HarshParmar029/ESP32-Smart-Visitor-Counter/ESP32_Visitor_Counter.pdf

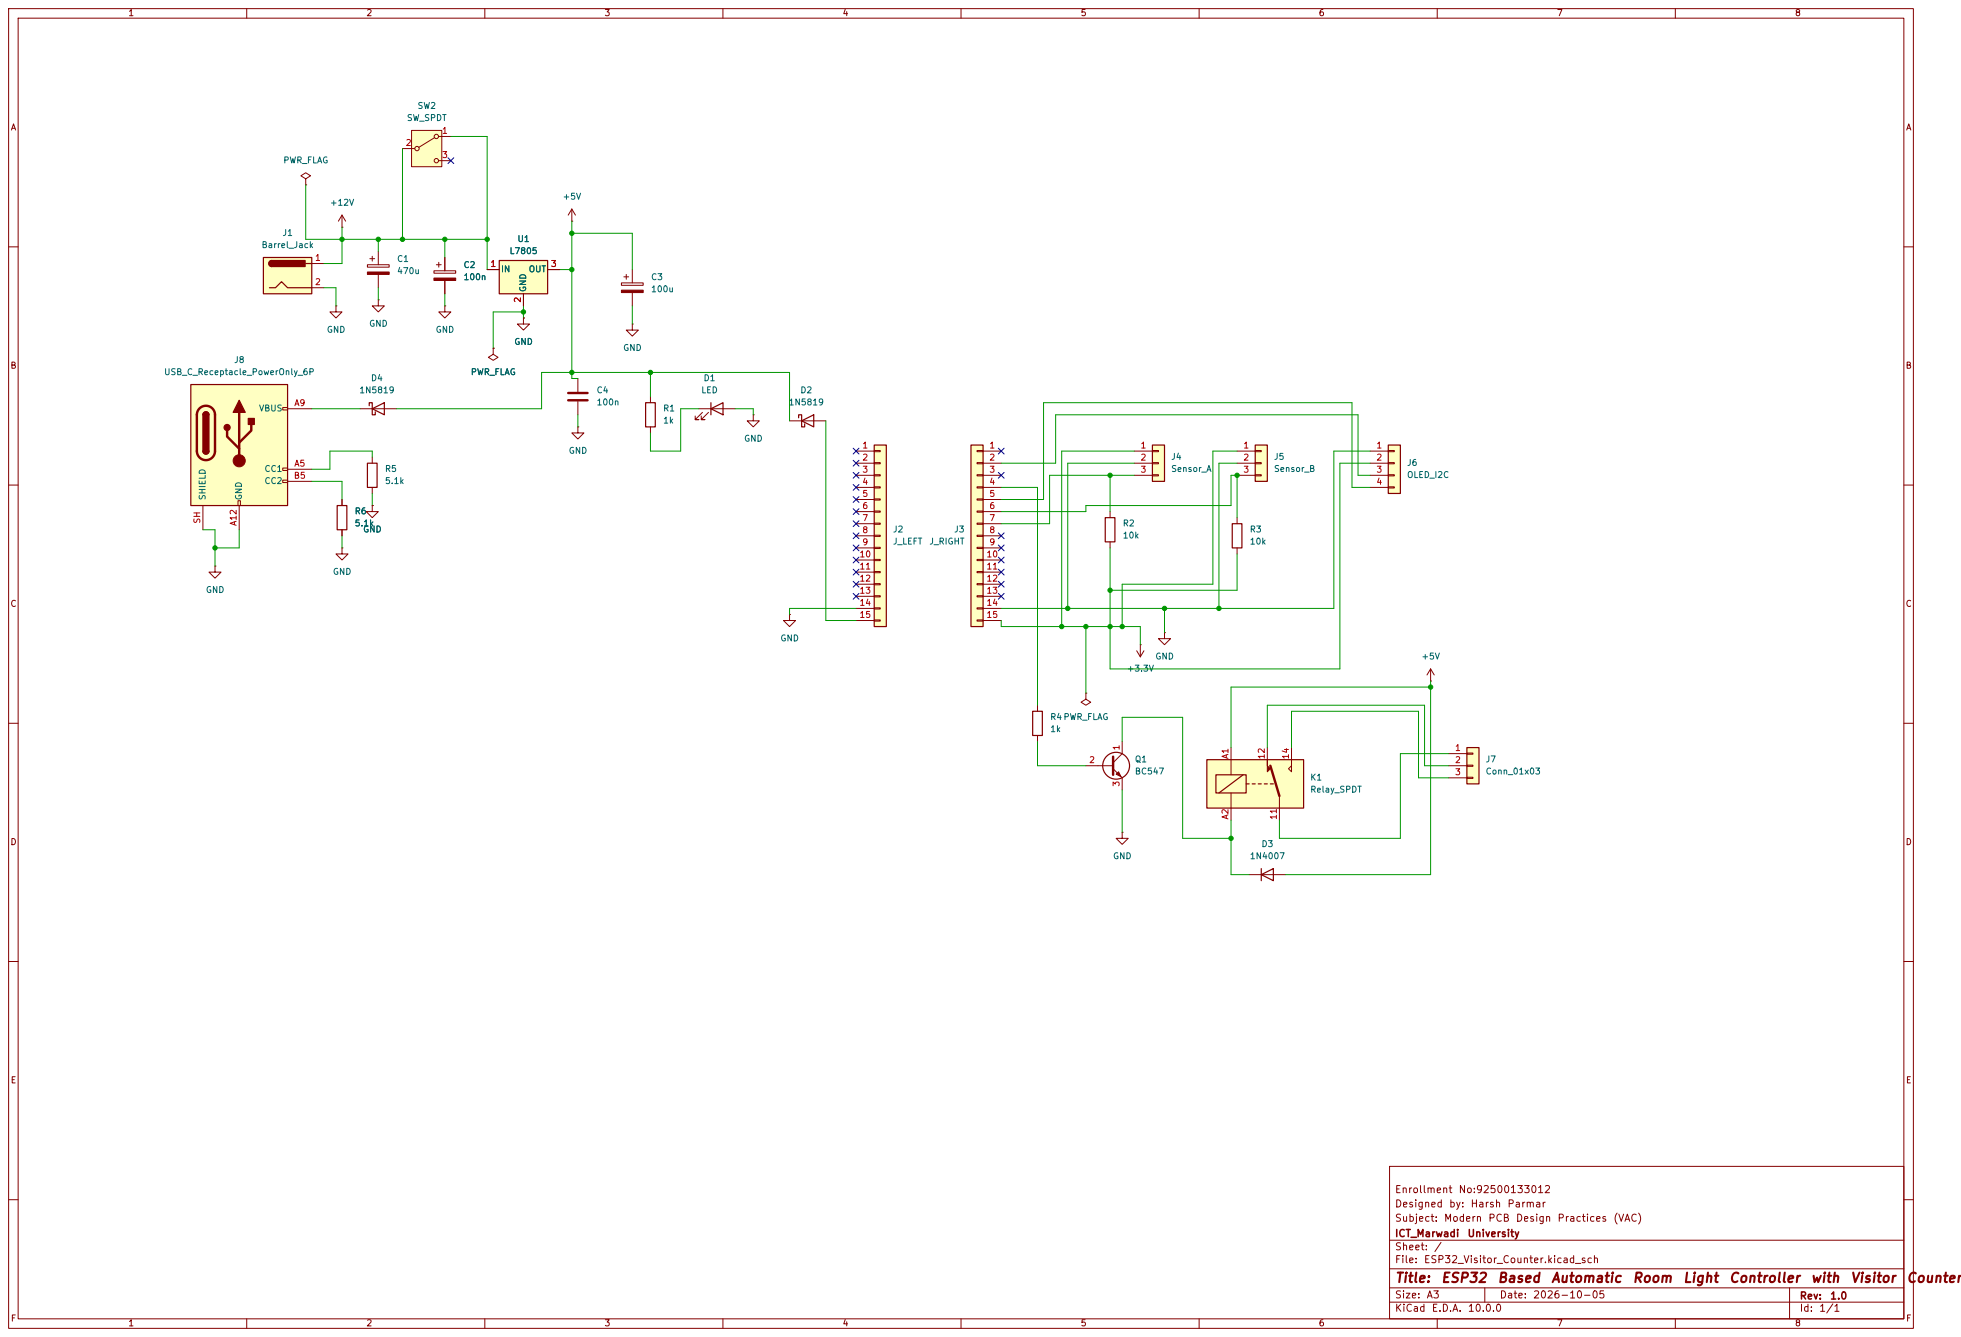
[picture p1: page 1]

Designed by: Harsh Parmar Enrollment No:92500133012

Subject: Modern PCB Design Practices (VAC)
ICT_Marwadi University
Sheet: /
File: ESP32_Visitor_Counter.kicad_sch

Size: A3 | Rev: 1.0 | F Date: 2026-10-05 KiCad E.D.A. 10.0.0
