HarshParmar029/ESP32-Smart-Visitor-Counter/ESP32_Smart_Visitor_Counter_Harsh_File.pdf

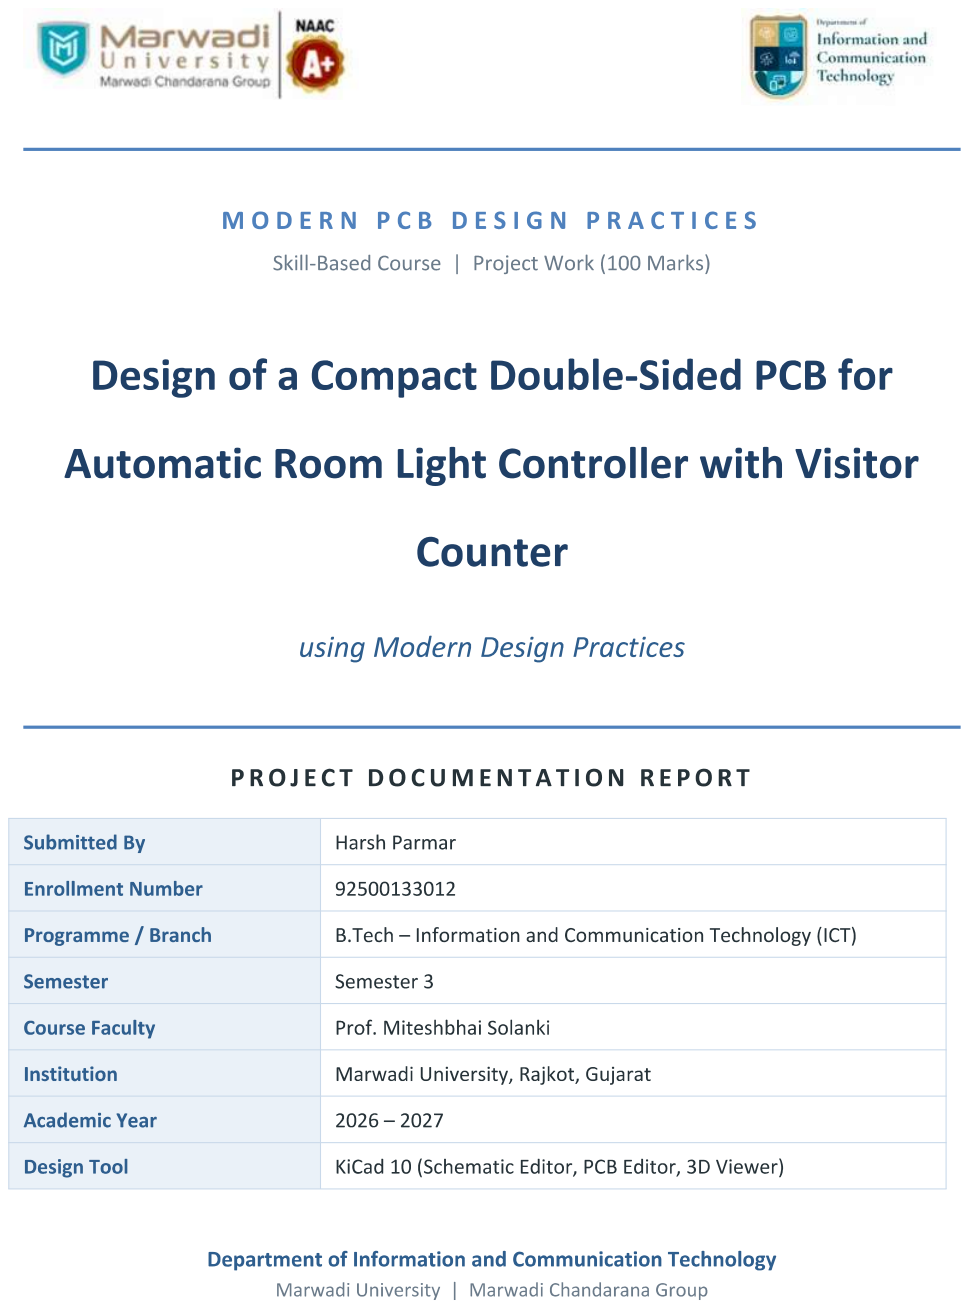
[picture p2: page 1]

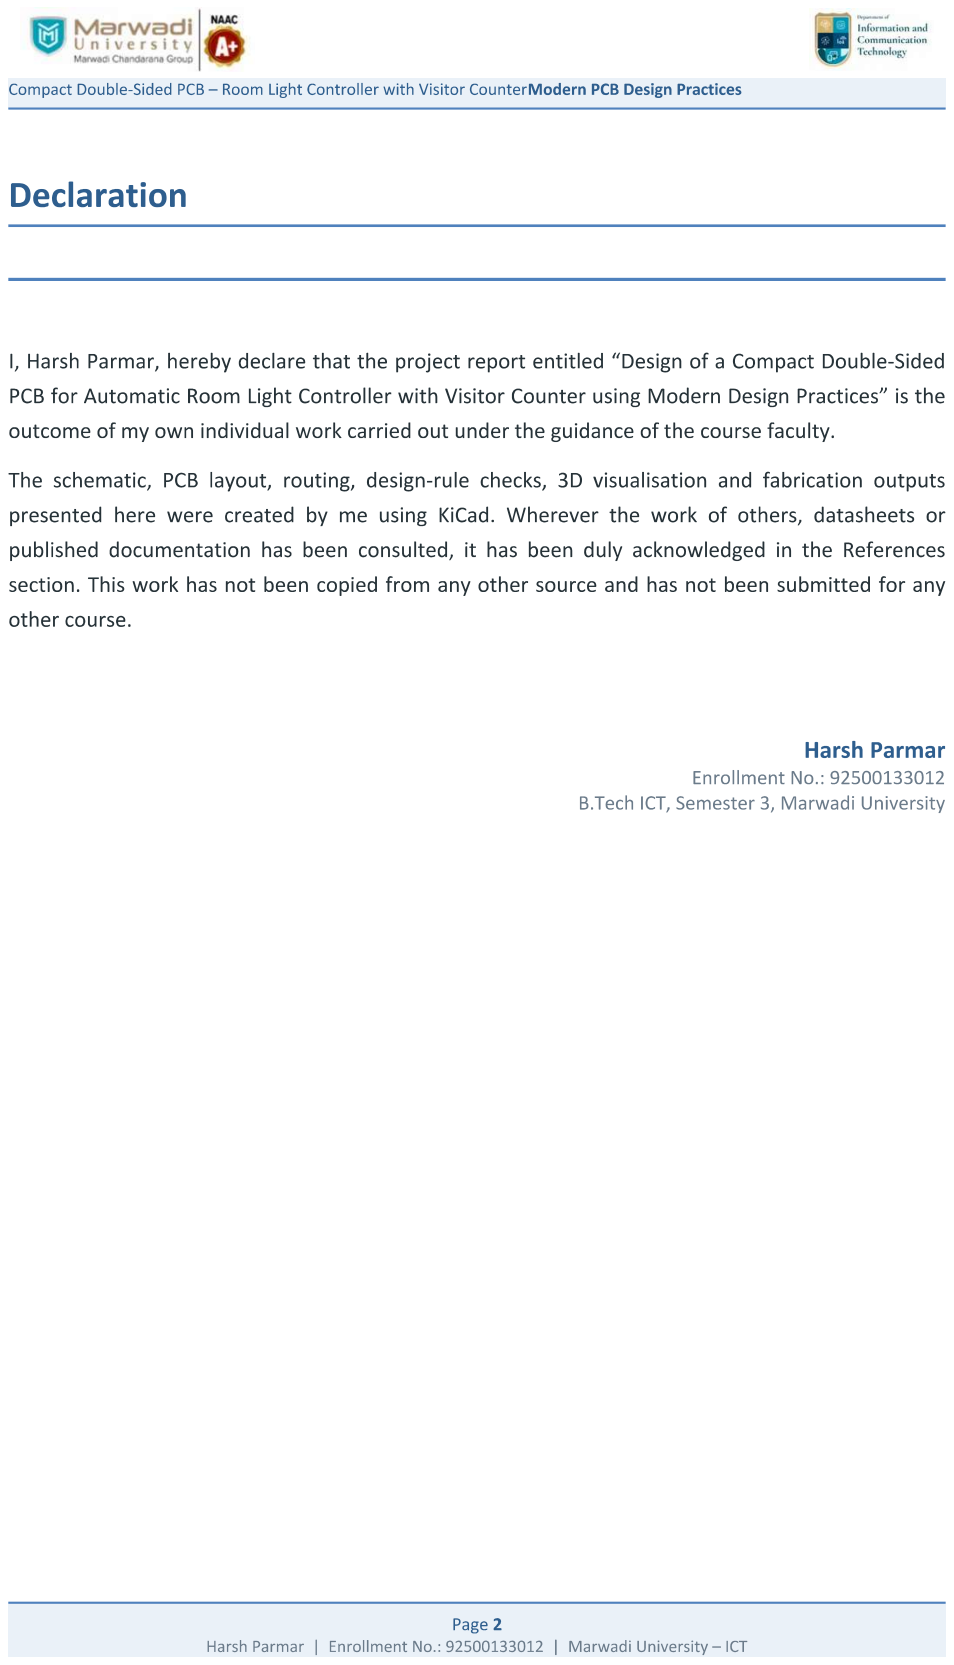
[picture p3: page 2]

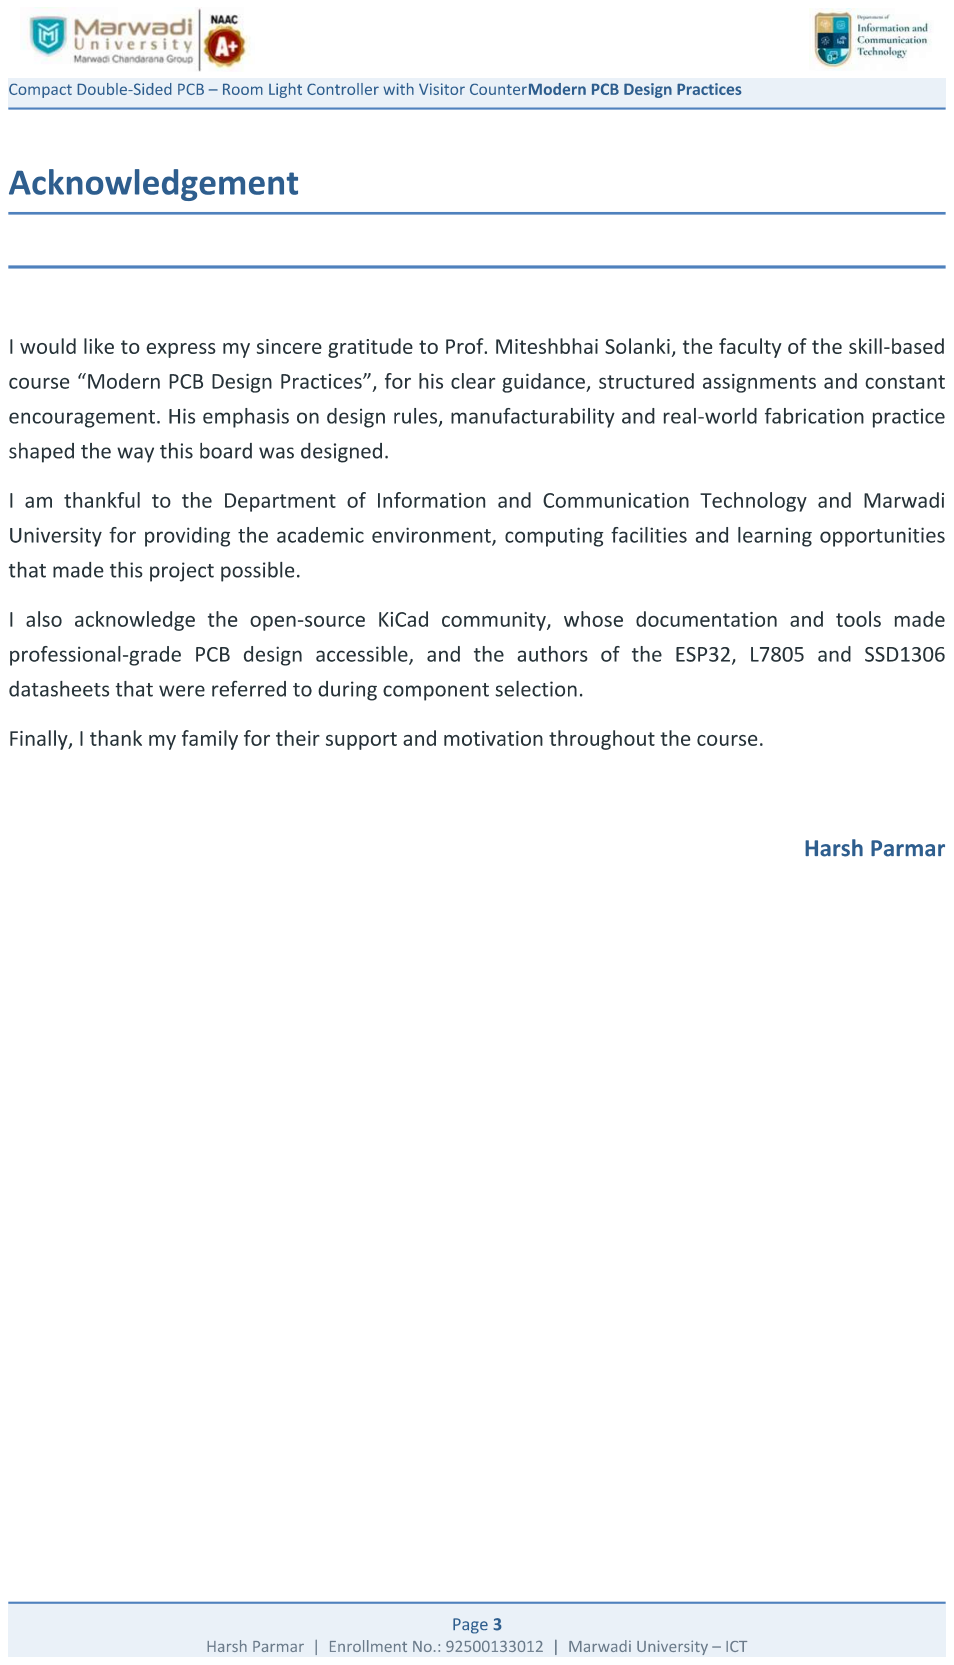
[picture p4: page 3]

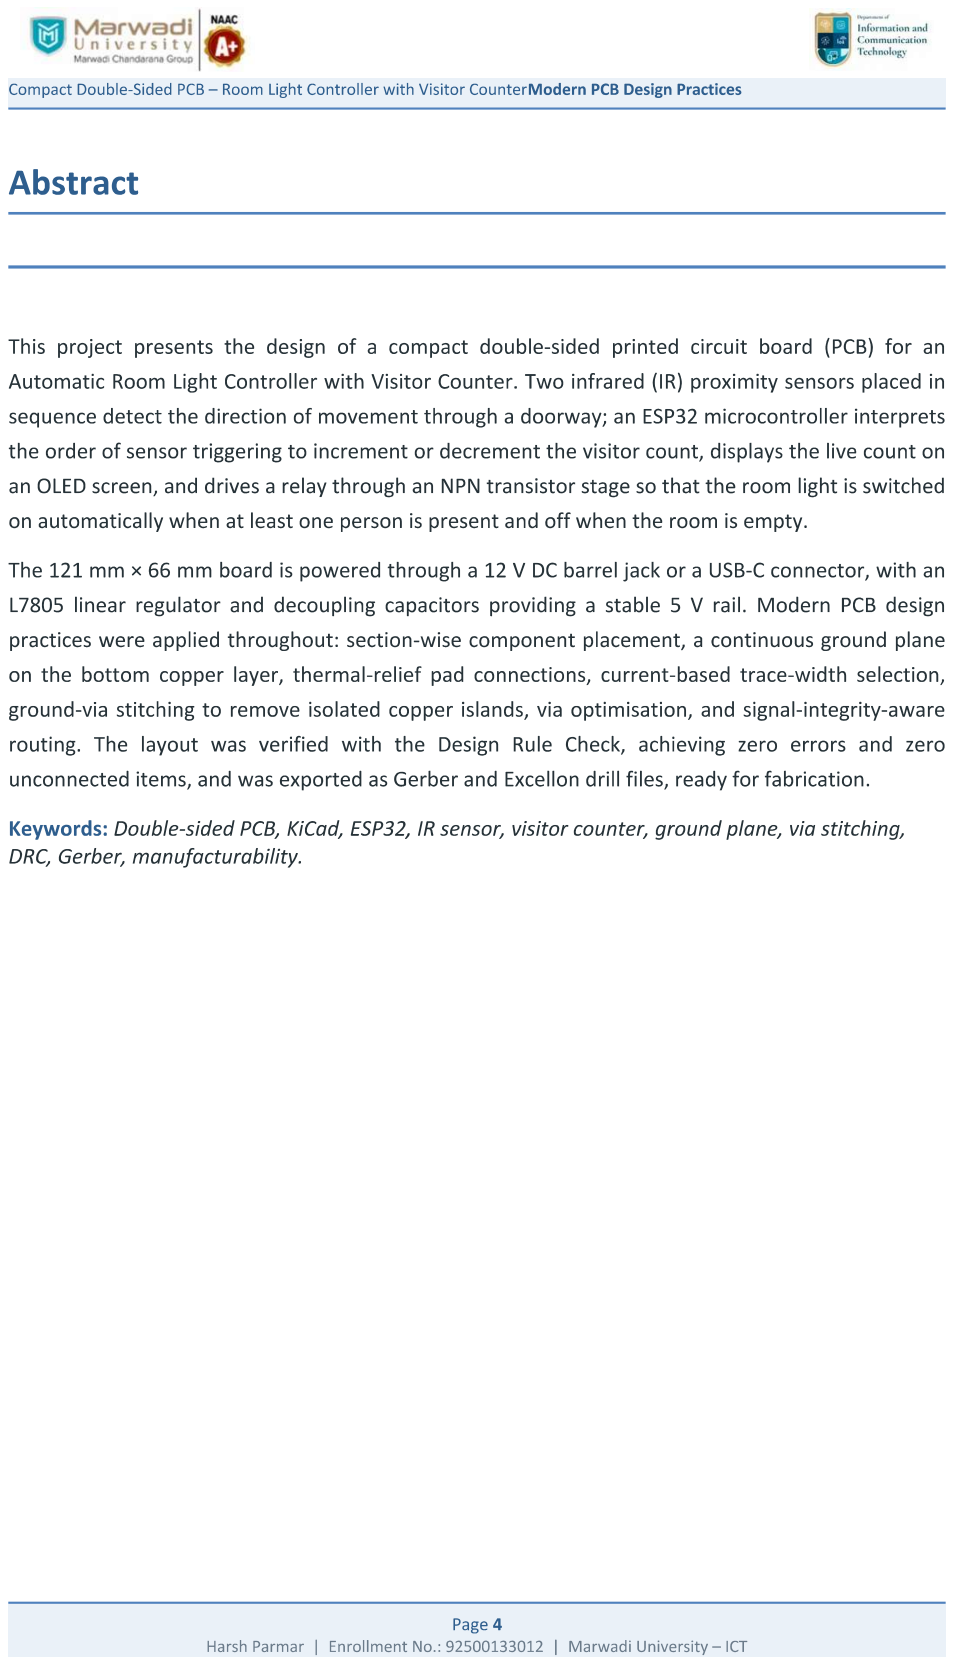
[picture p5: page 4]

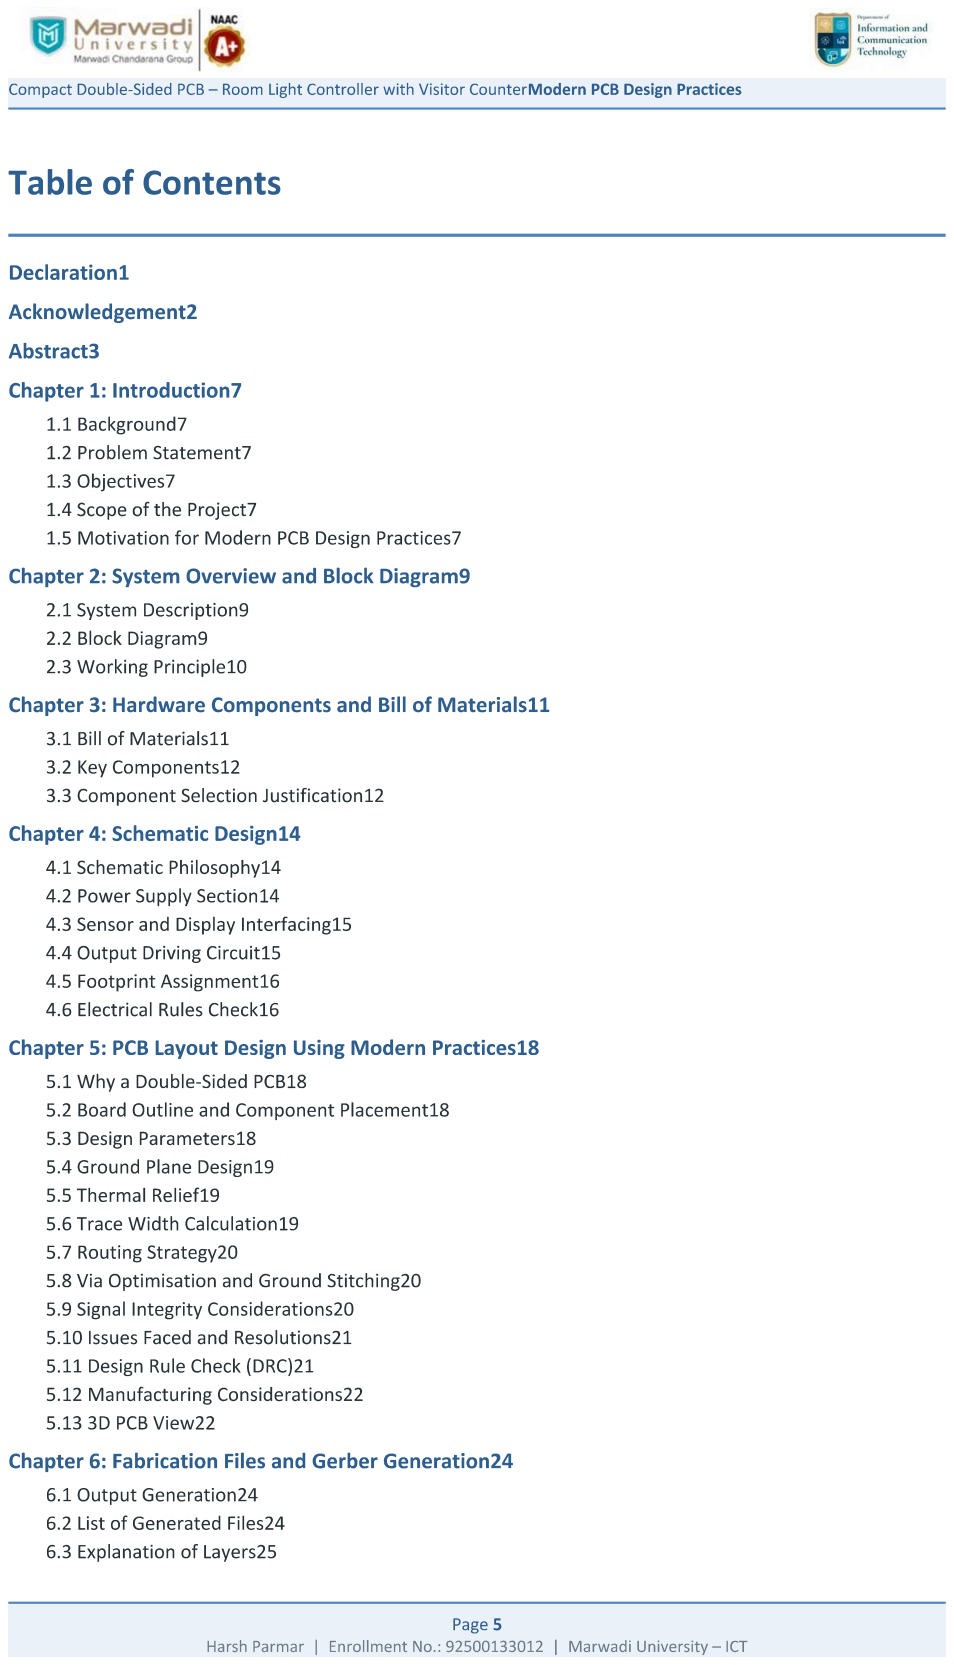
[picture p6: page 5]

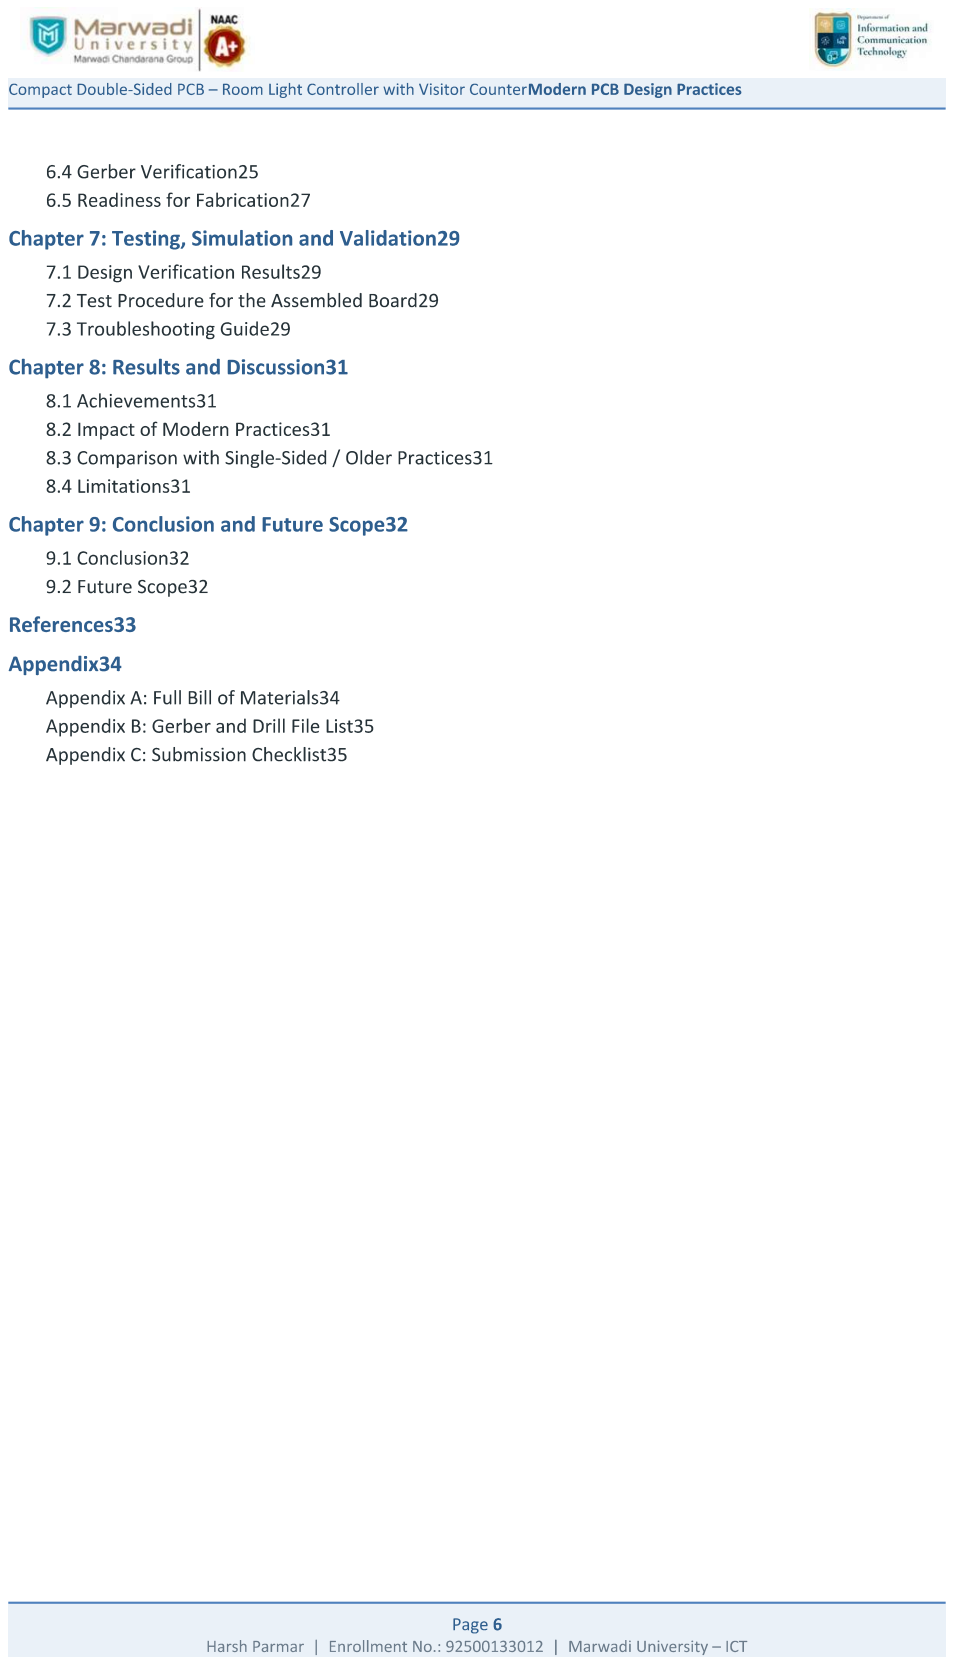
[picture p7: page 6]

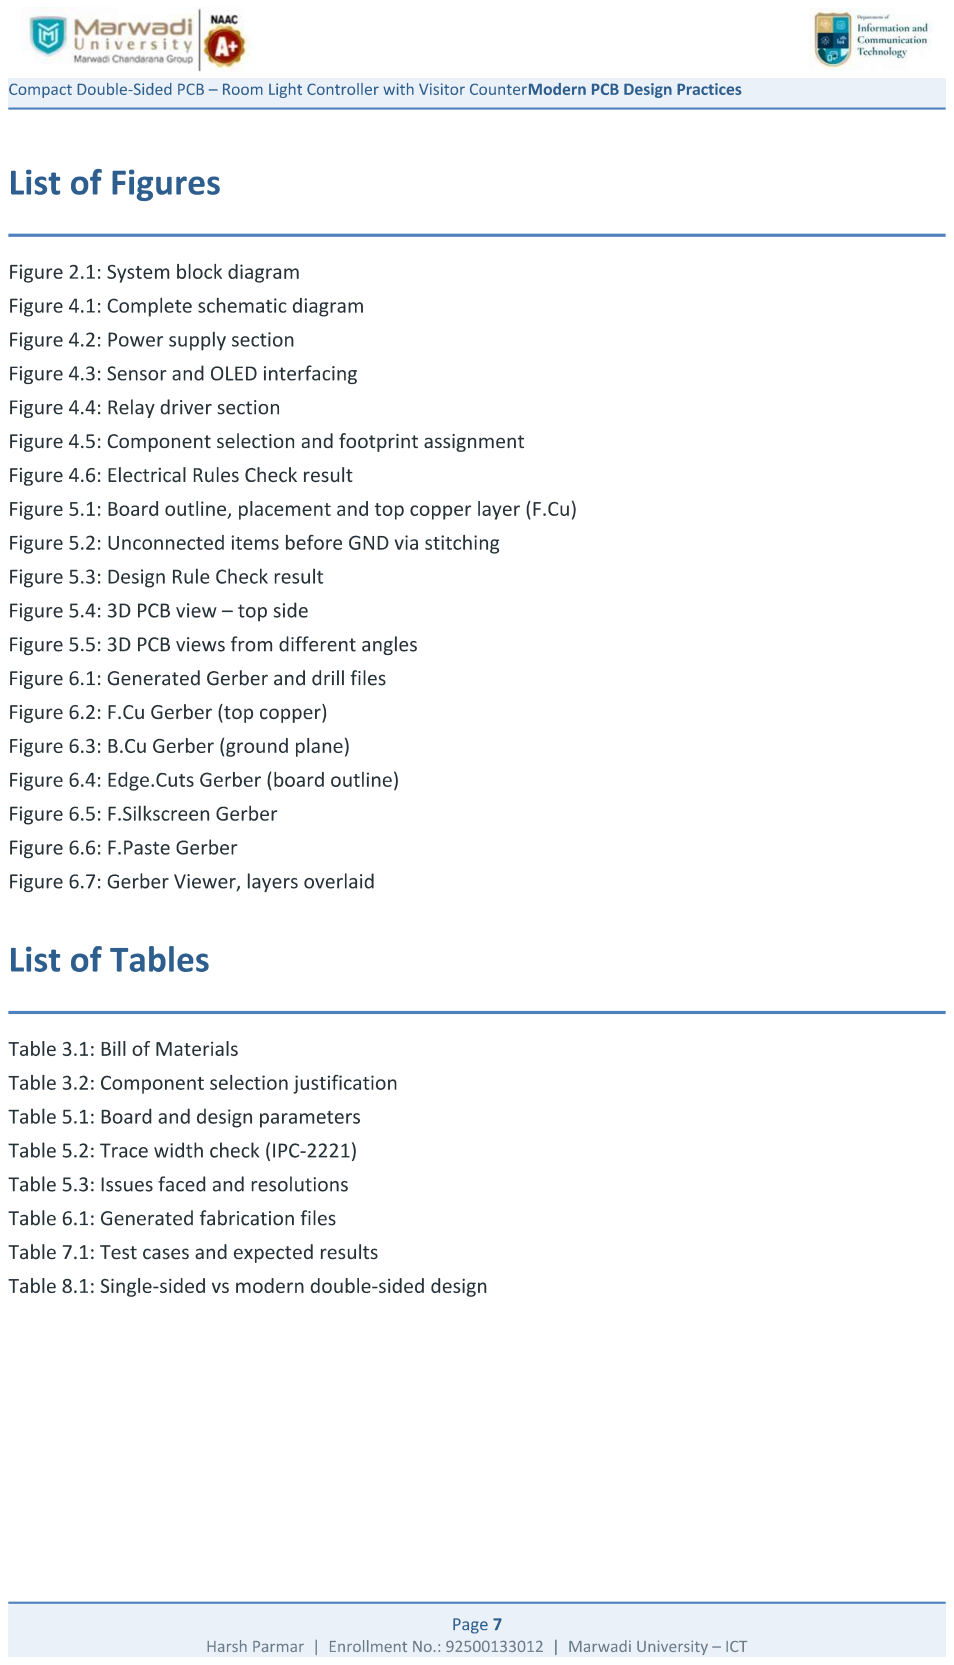
[picture p8: page 7]

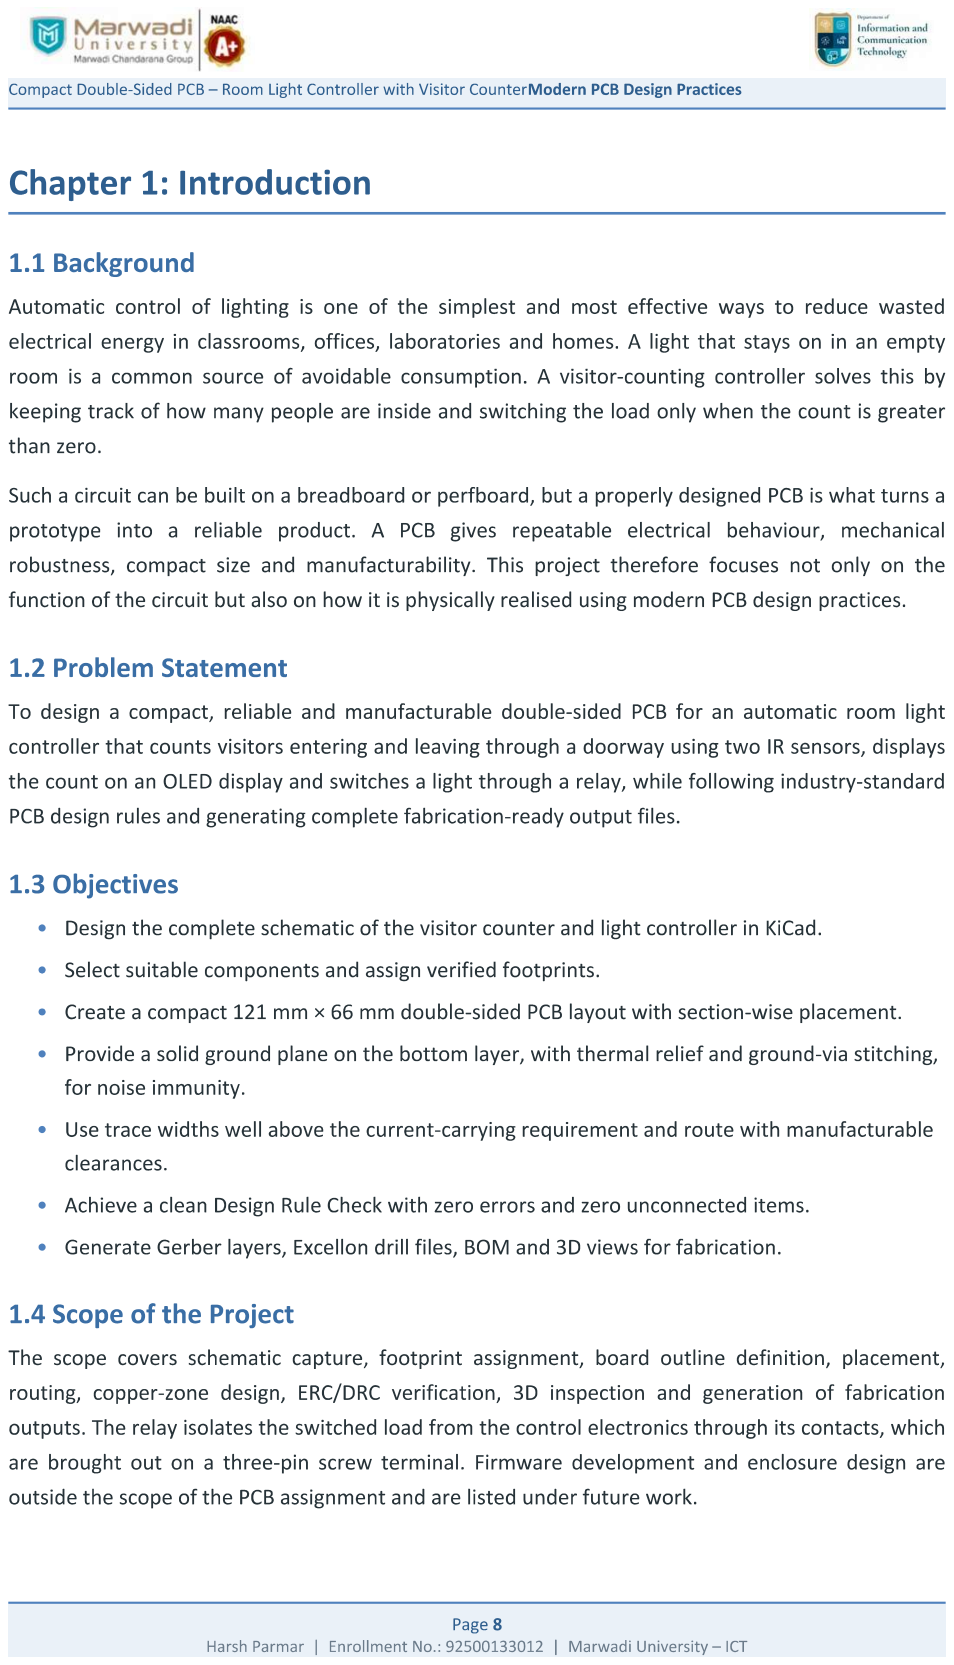
[picture p9: page 8]

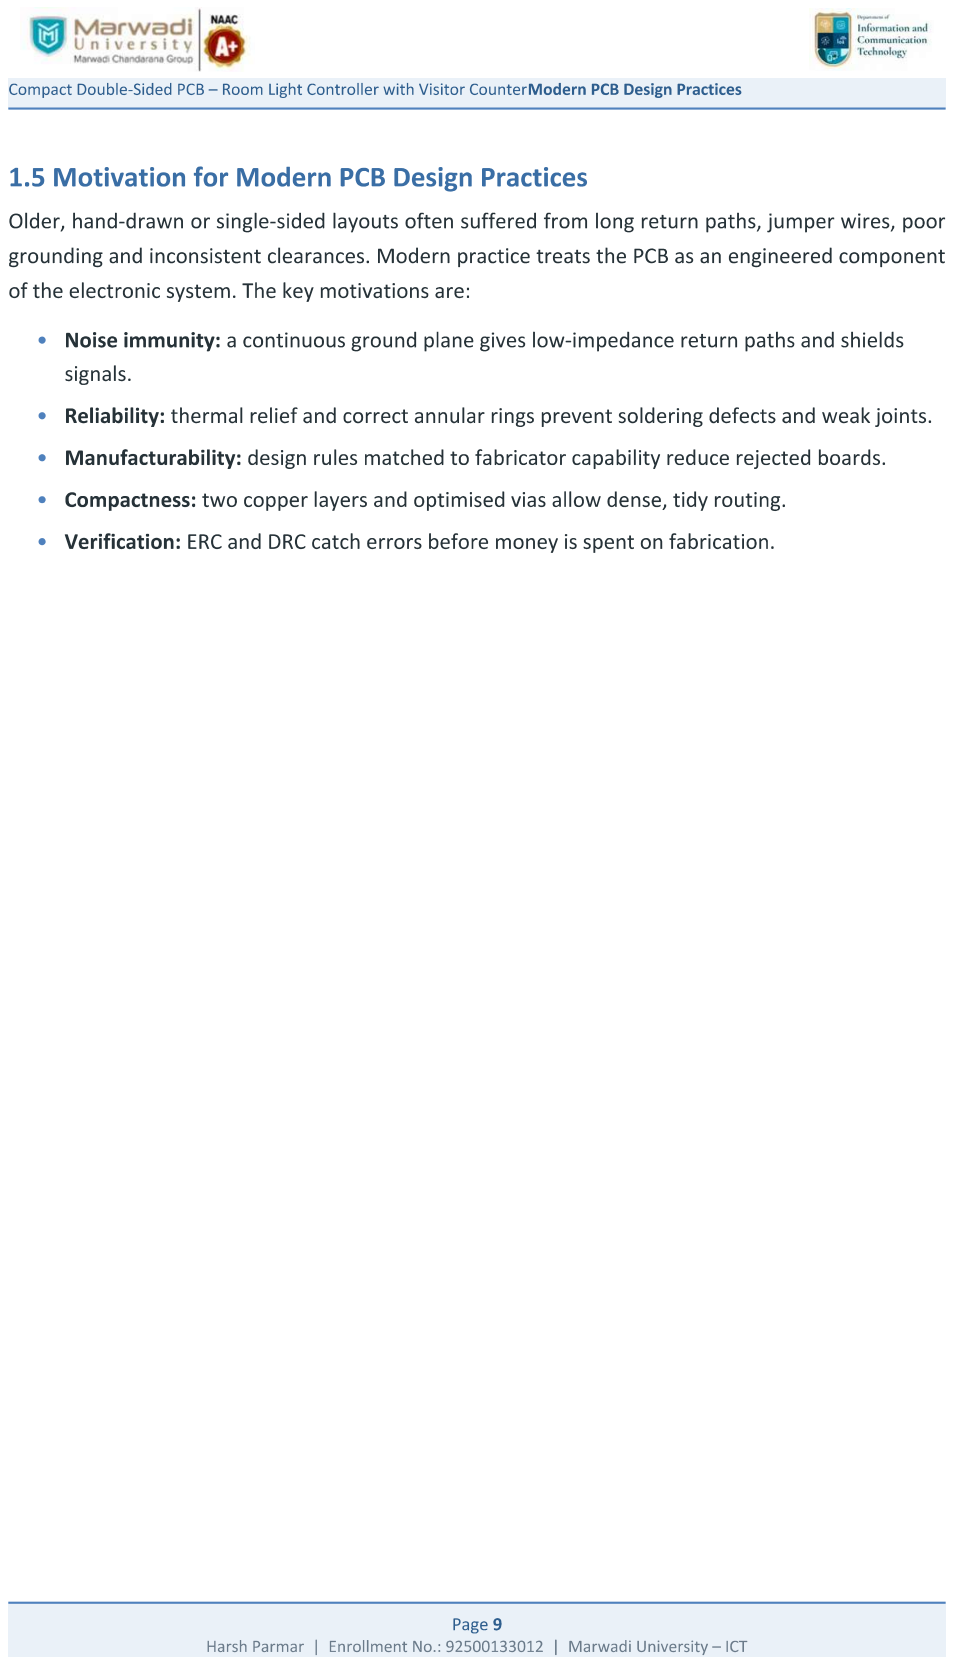
[picture p10: page 9]

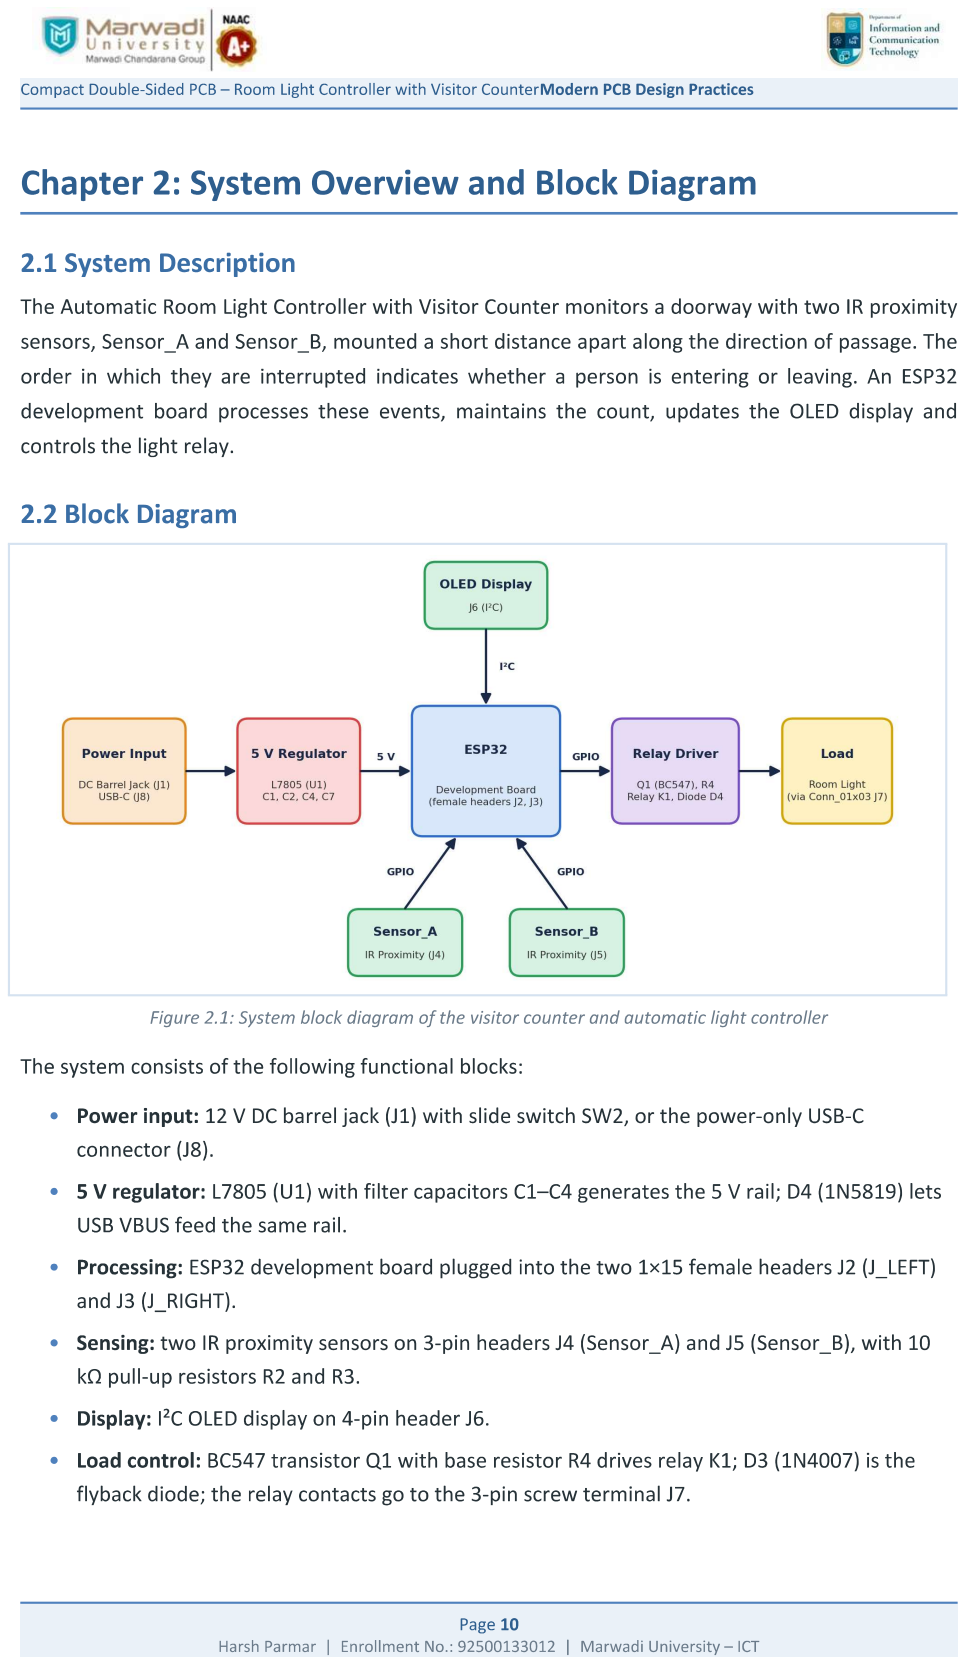
[picture p11: page 10]

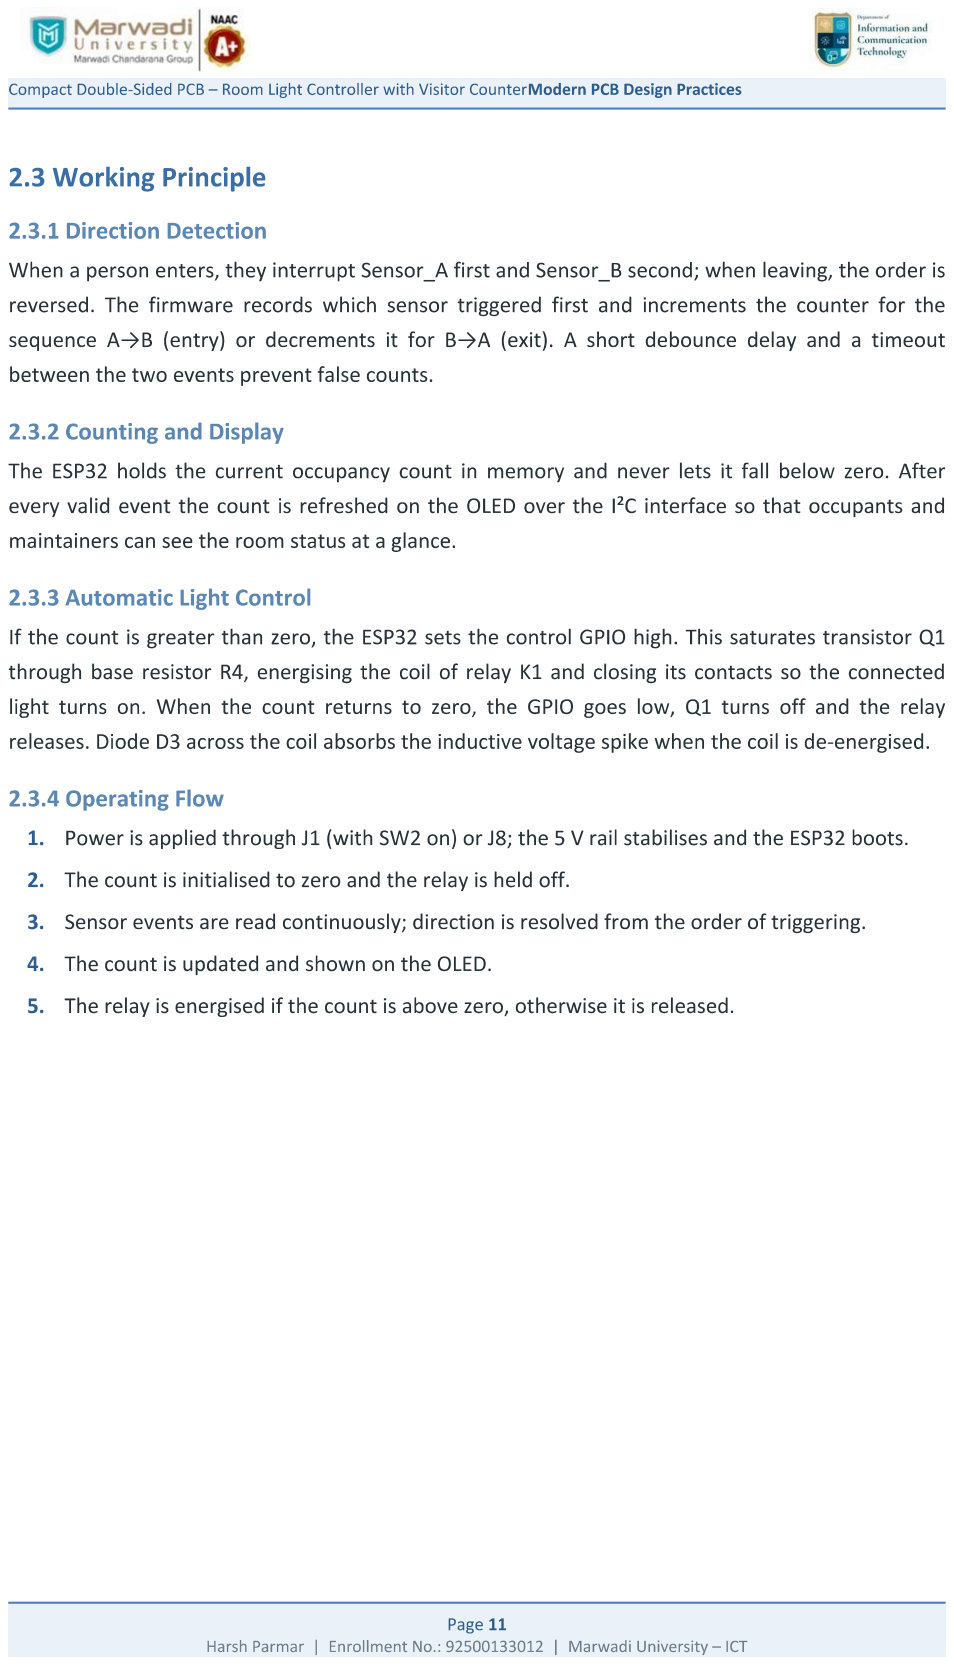
[picture p12: page 11]

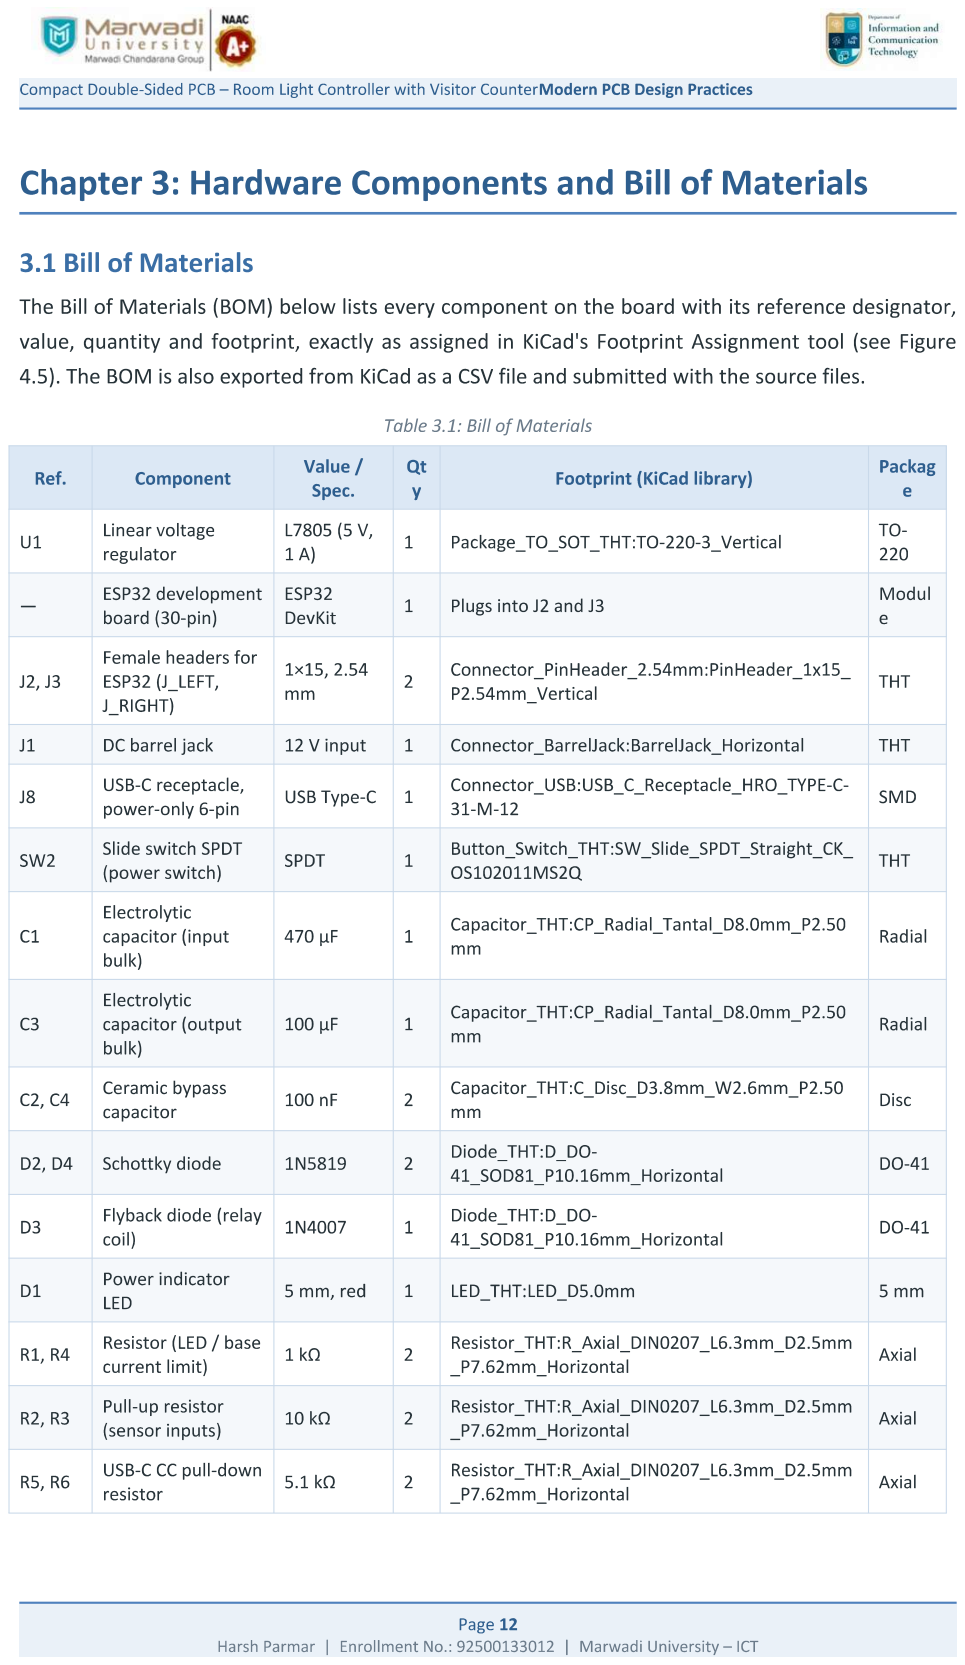
[picture p13: page 12]

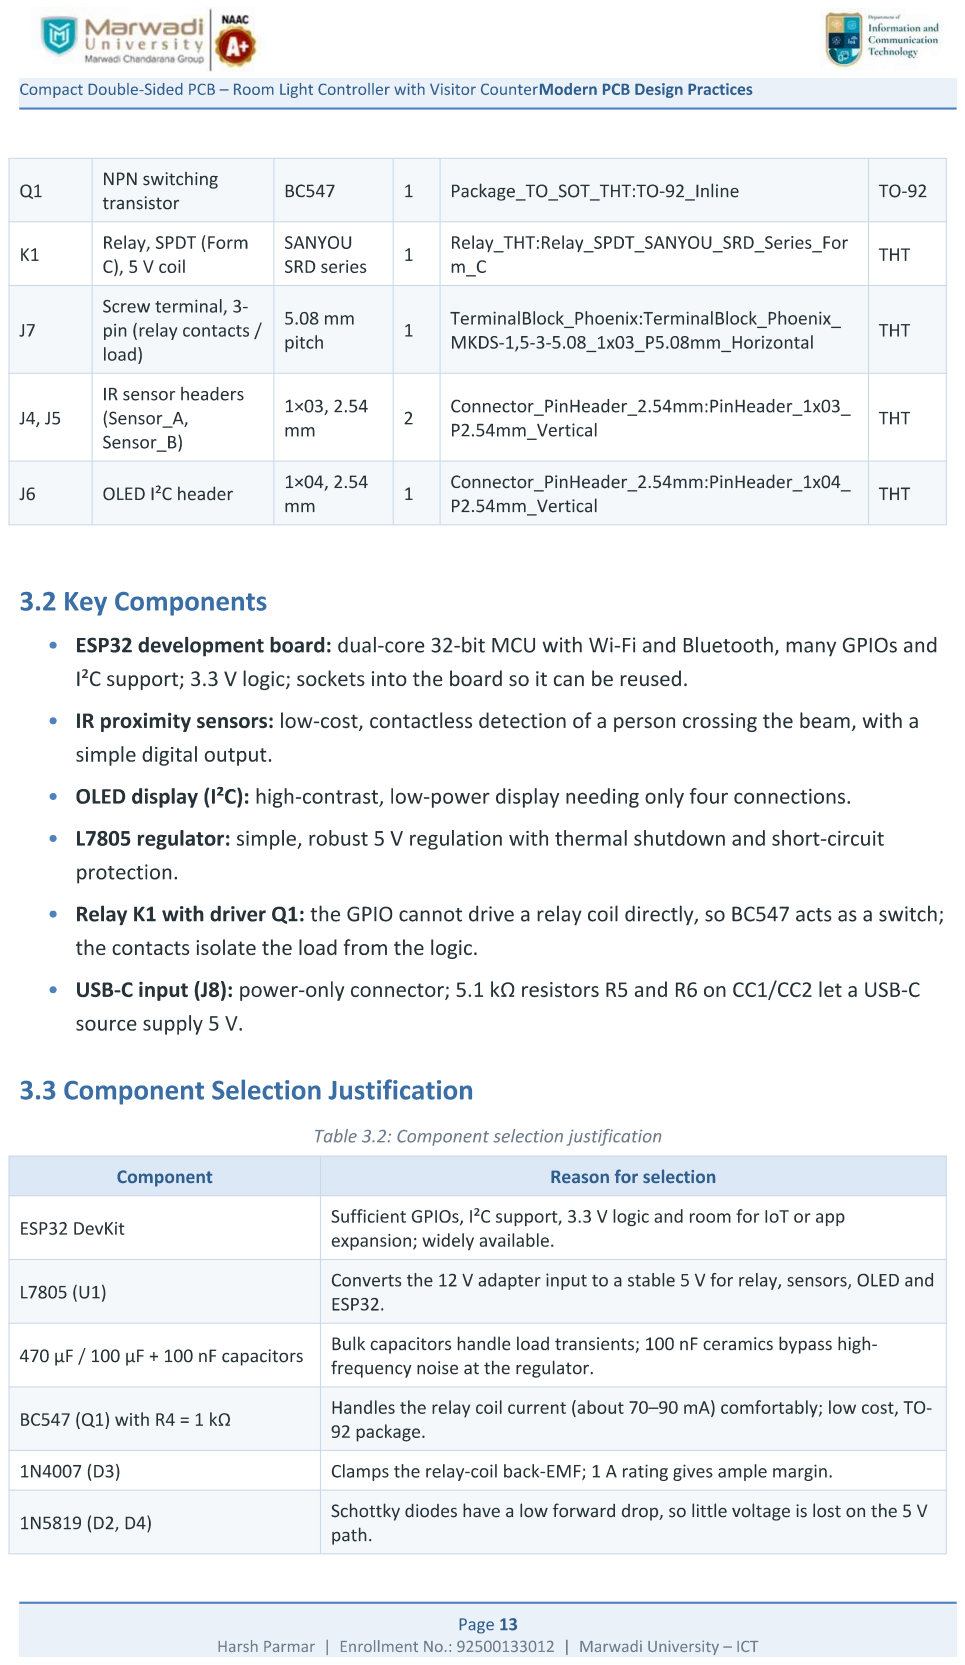
[picture p14: page 13]

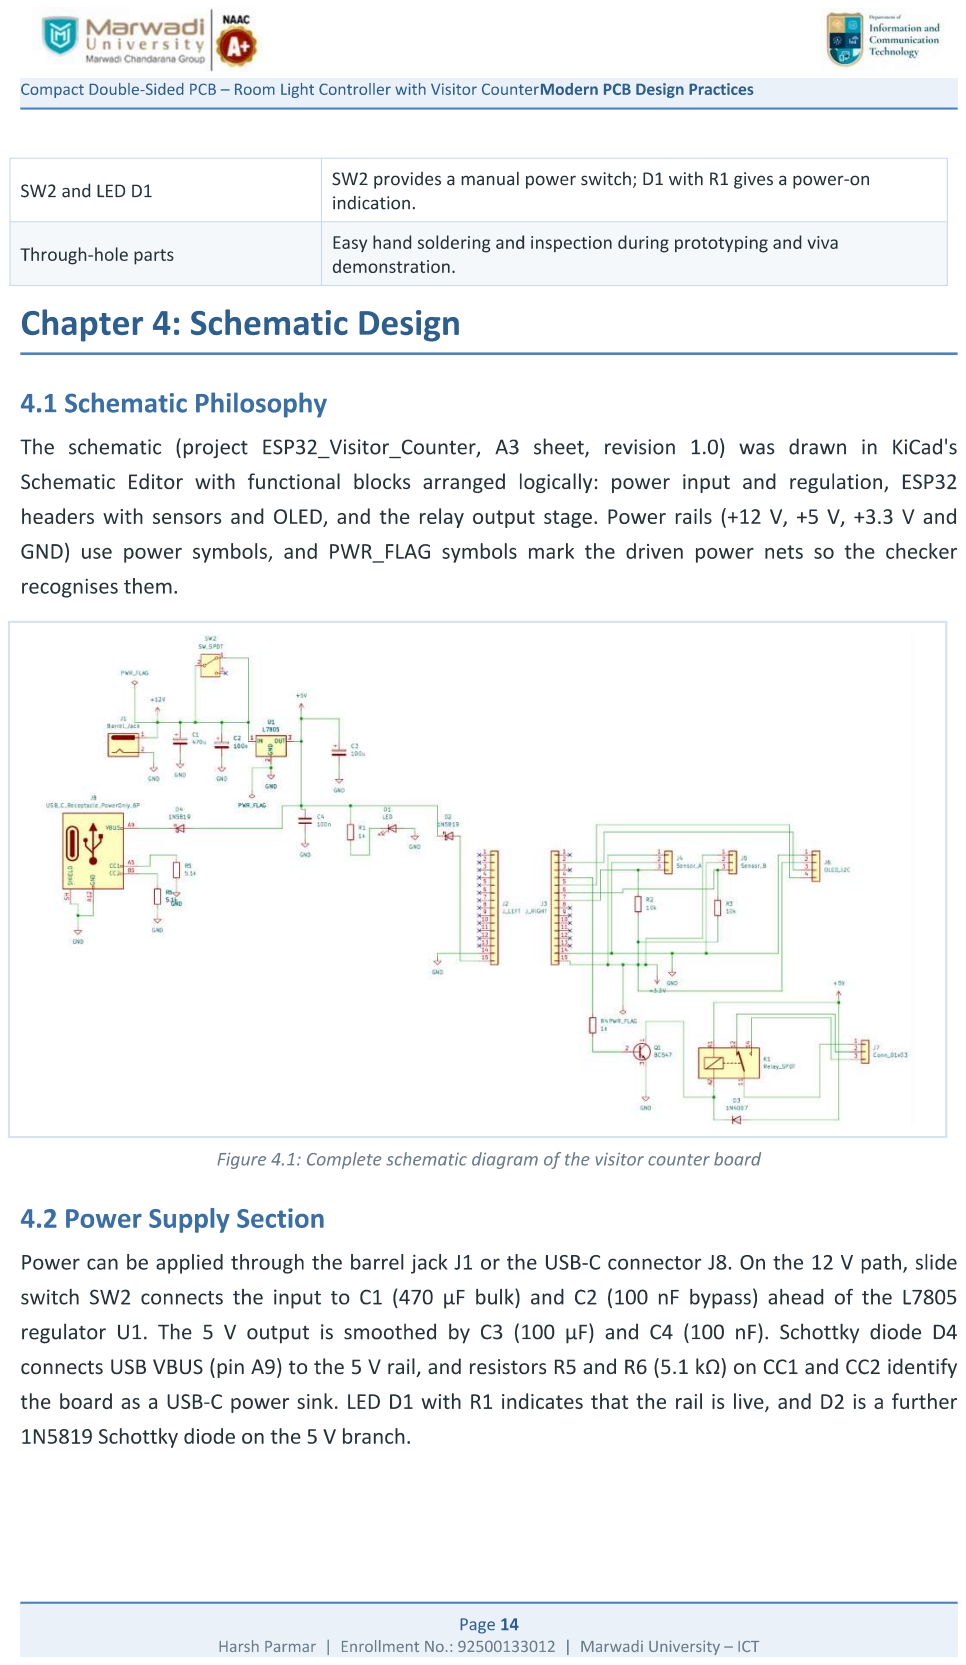
[picture p15: page 14]

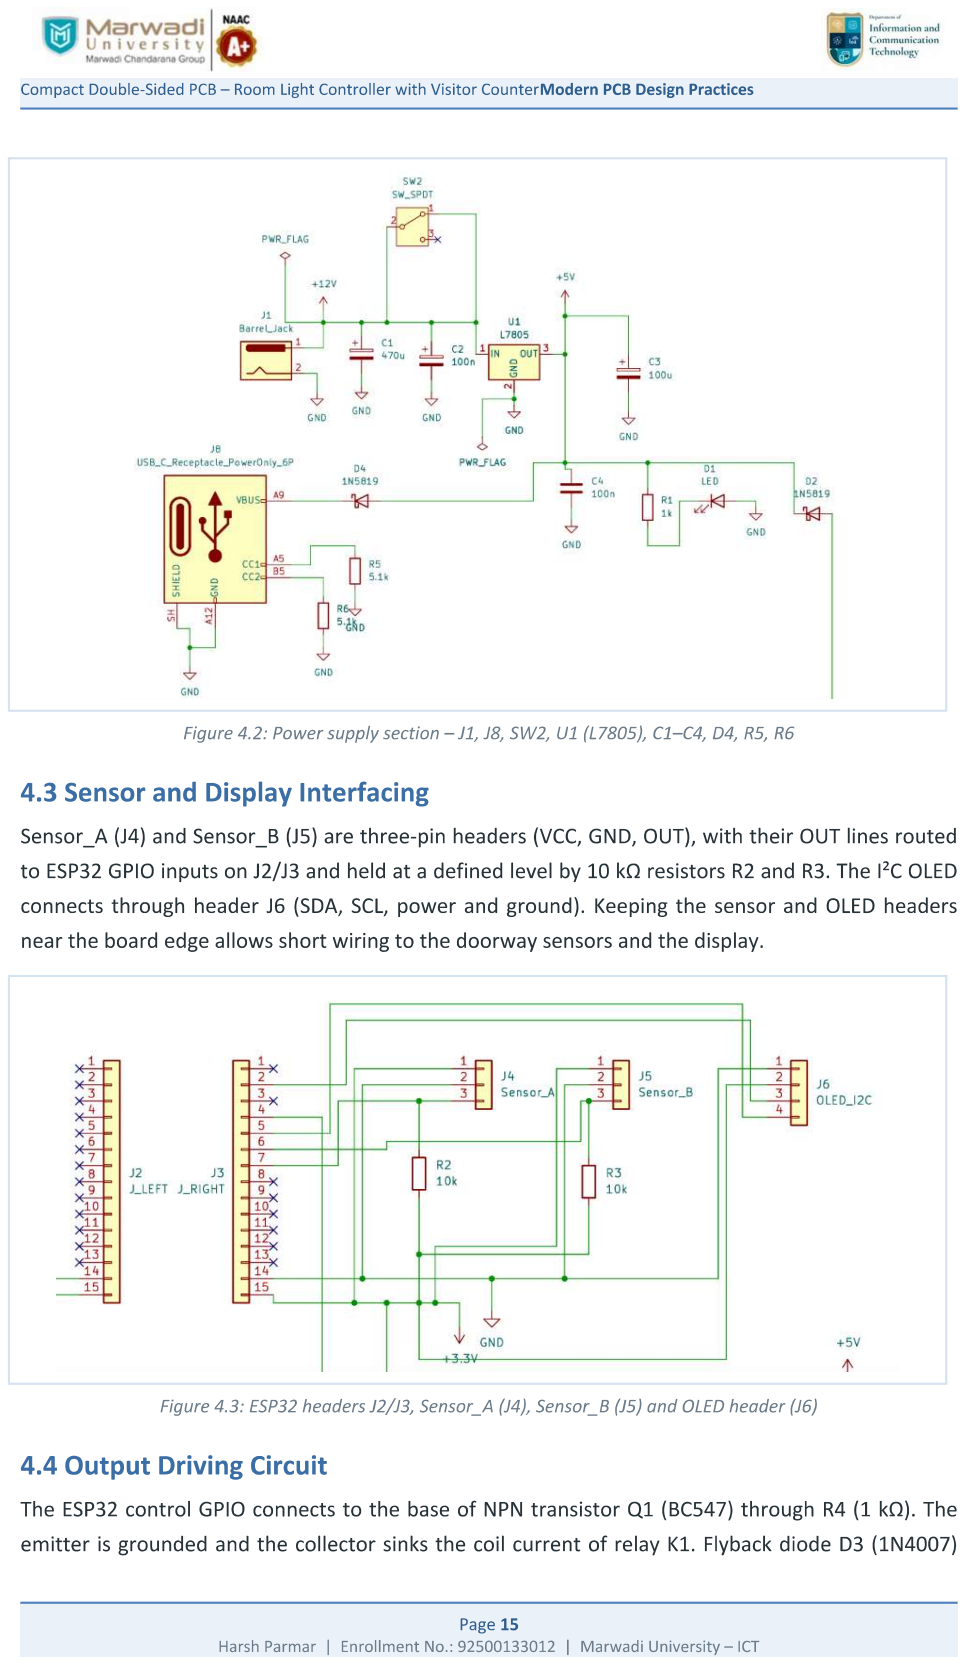
[picture p16: page 15]

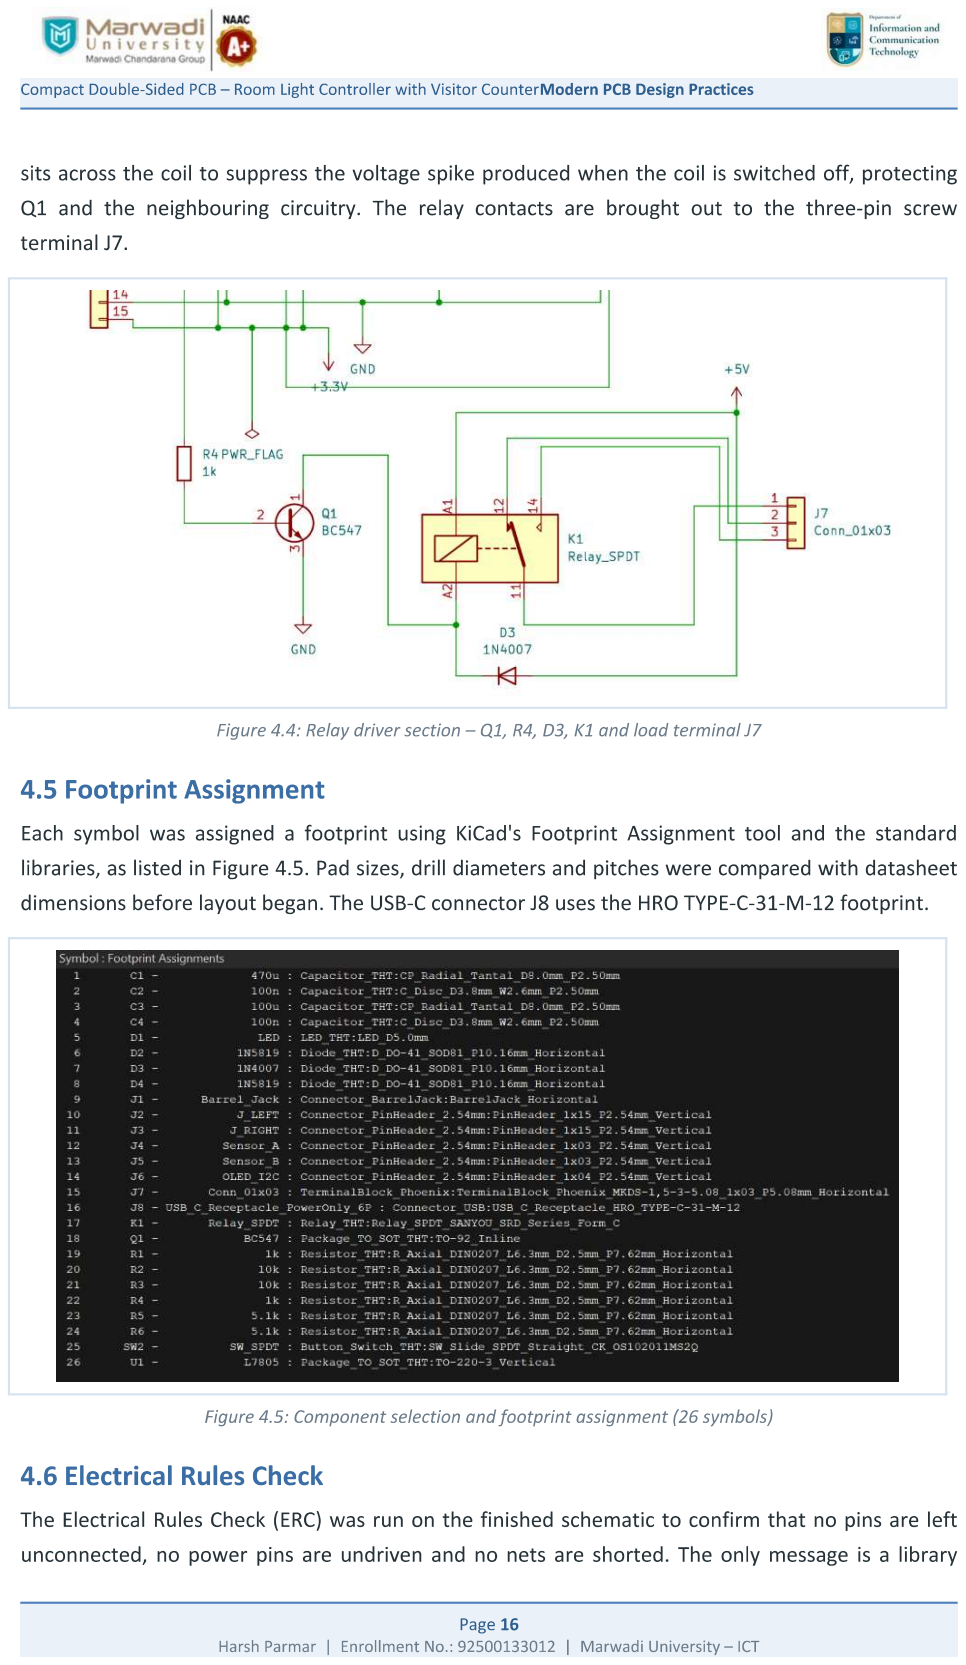
[picture p17: page 16]

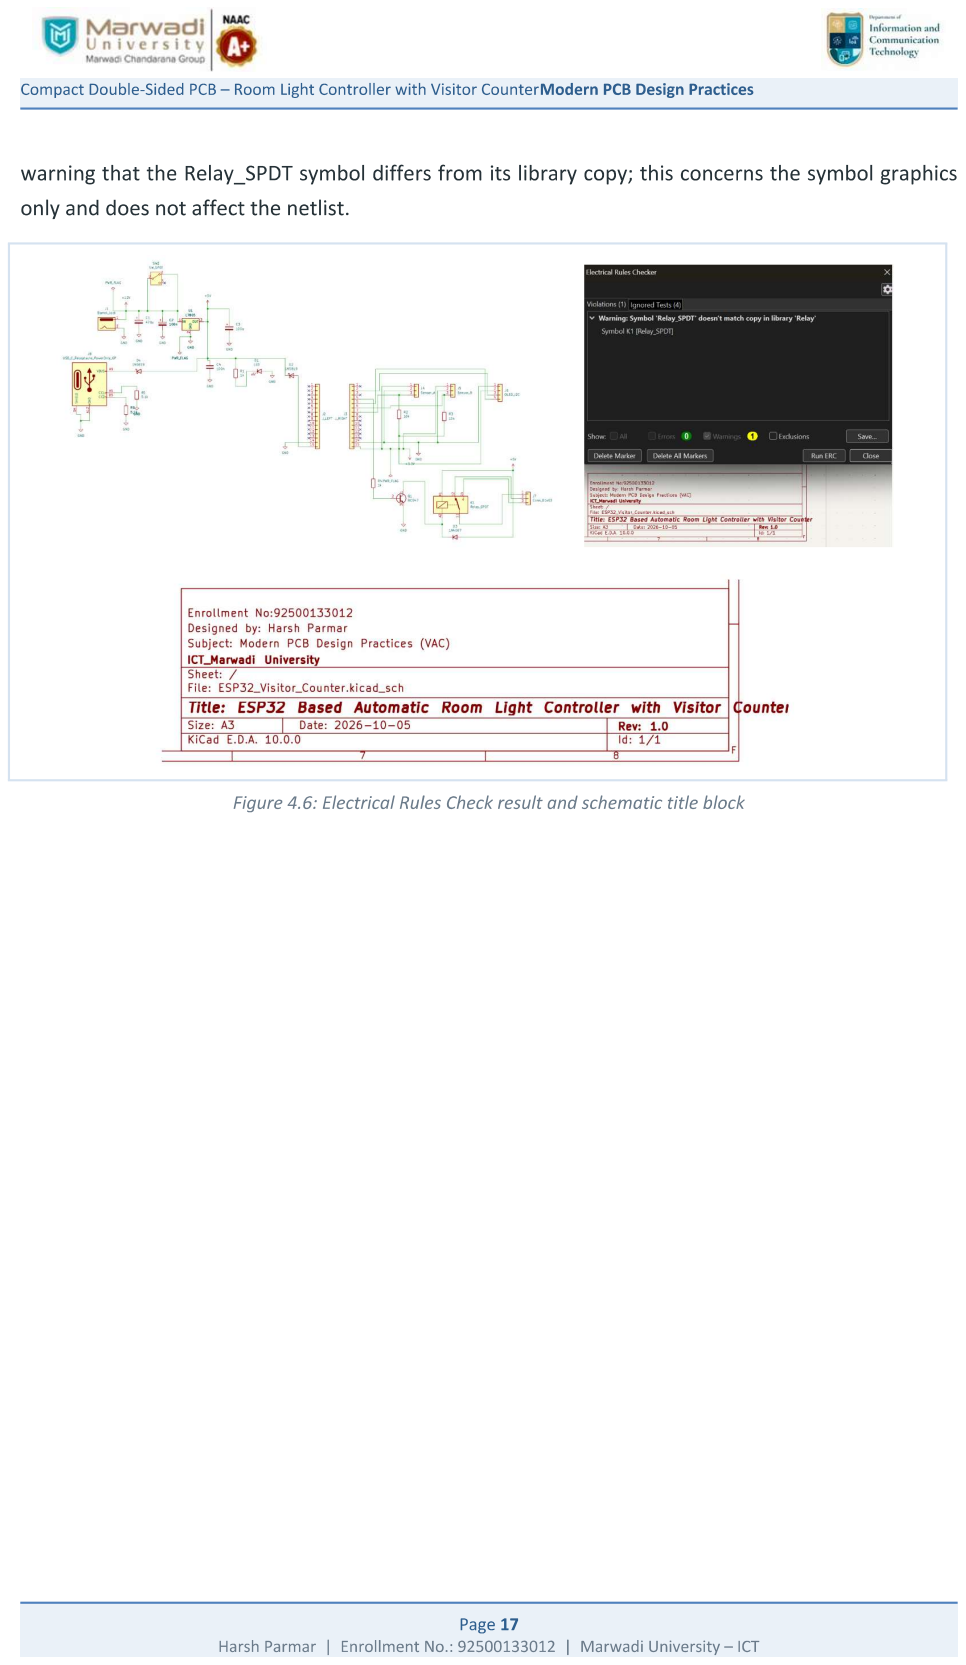
[picture p18: page 17]

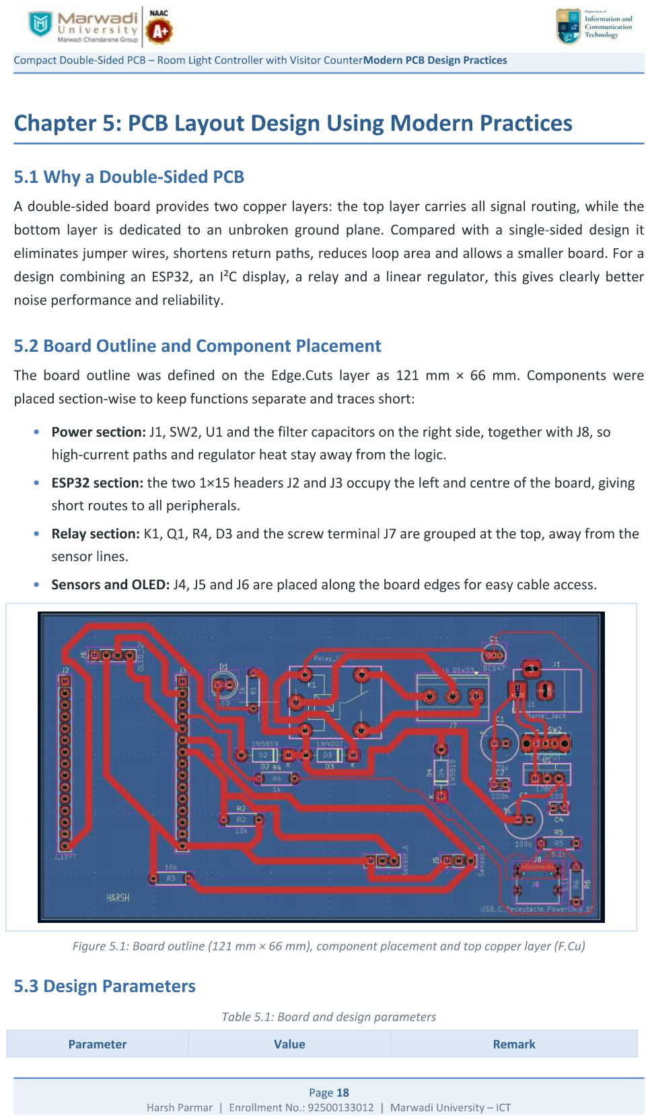
[picture p19: page 18]

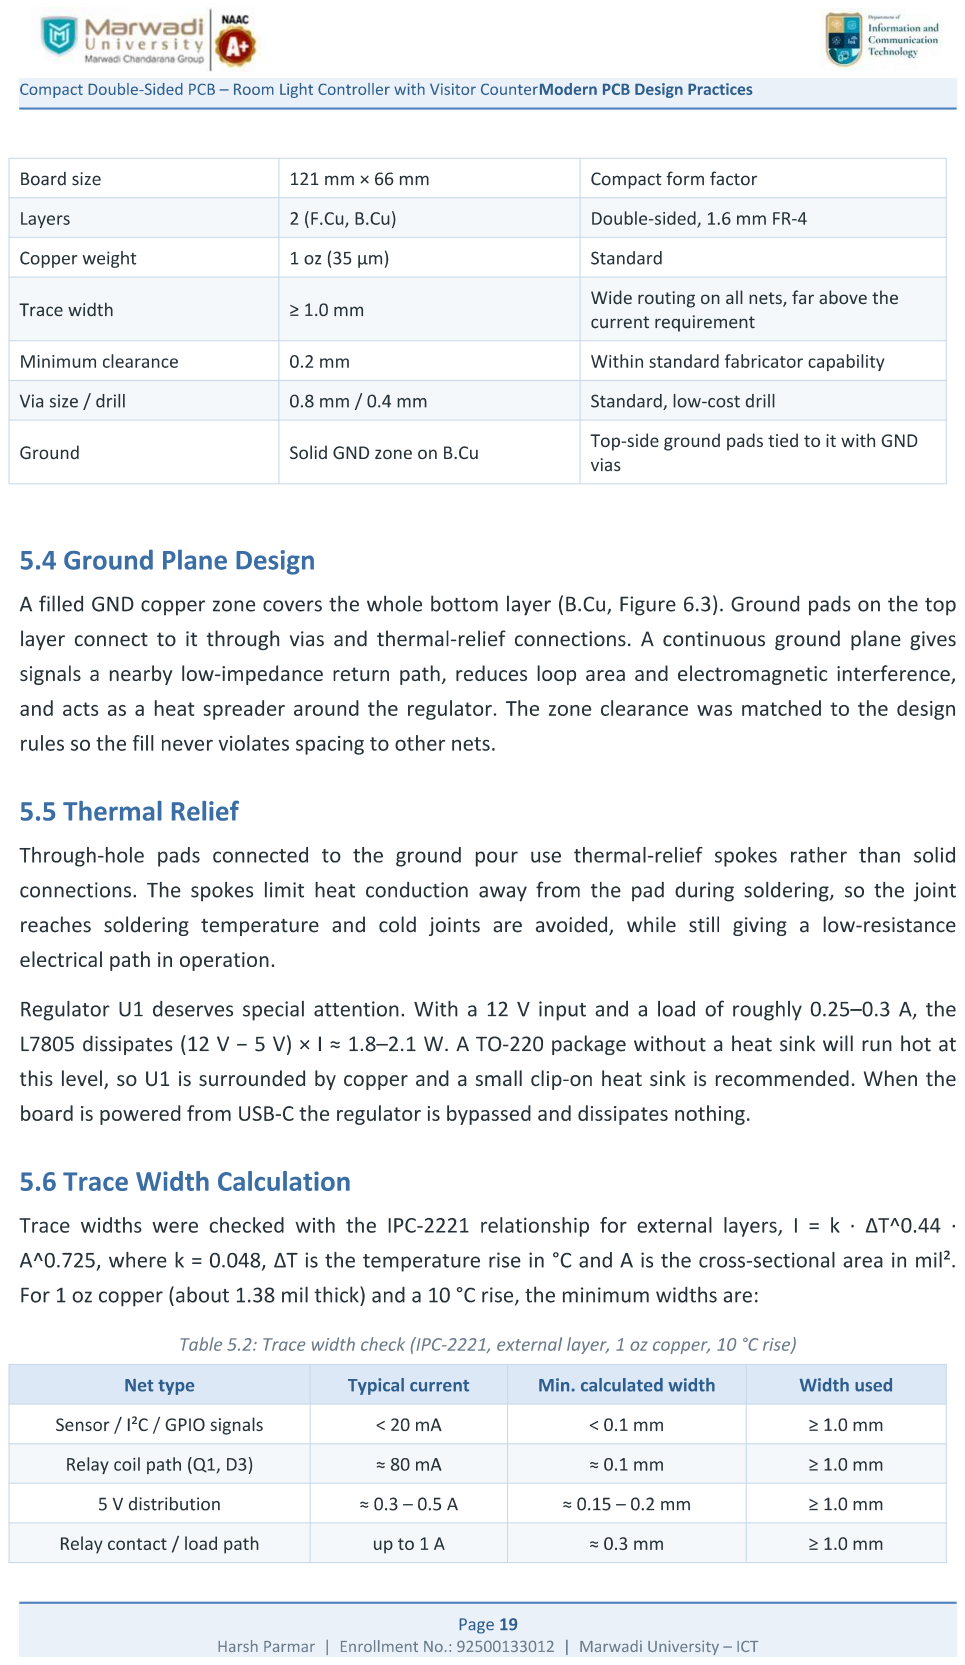
[picture p20: page 19]

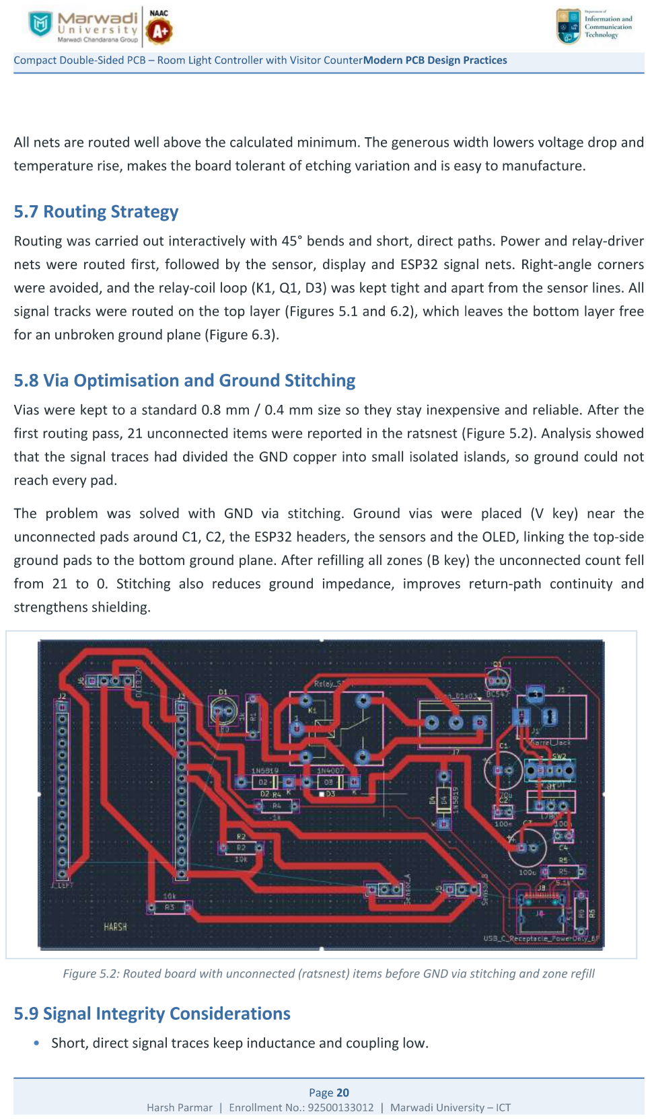
[picture p21: page 20]

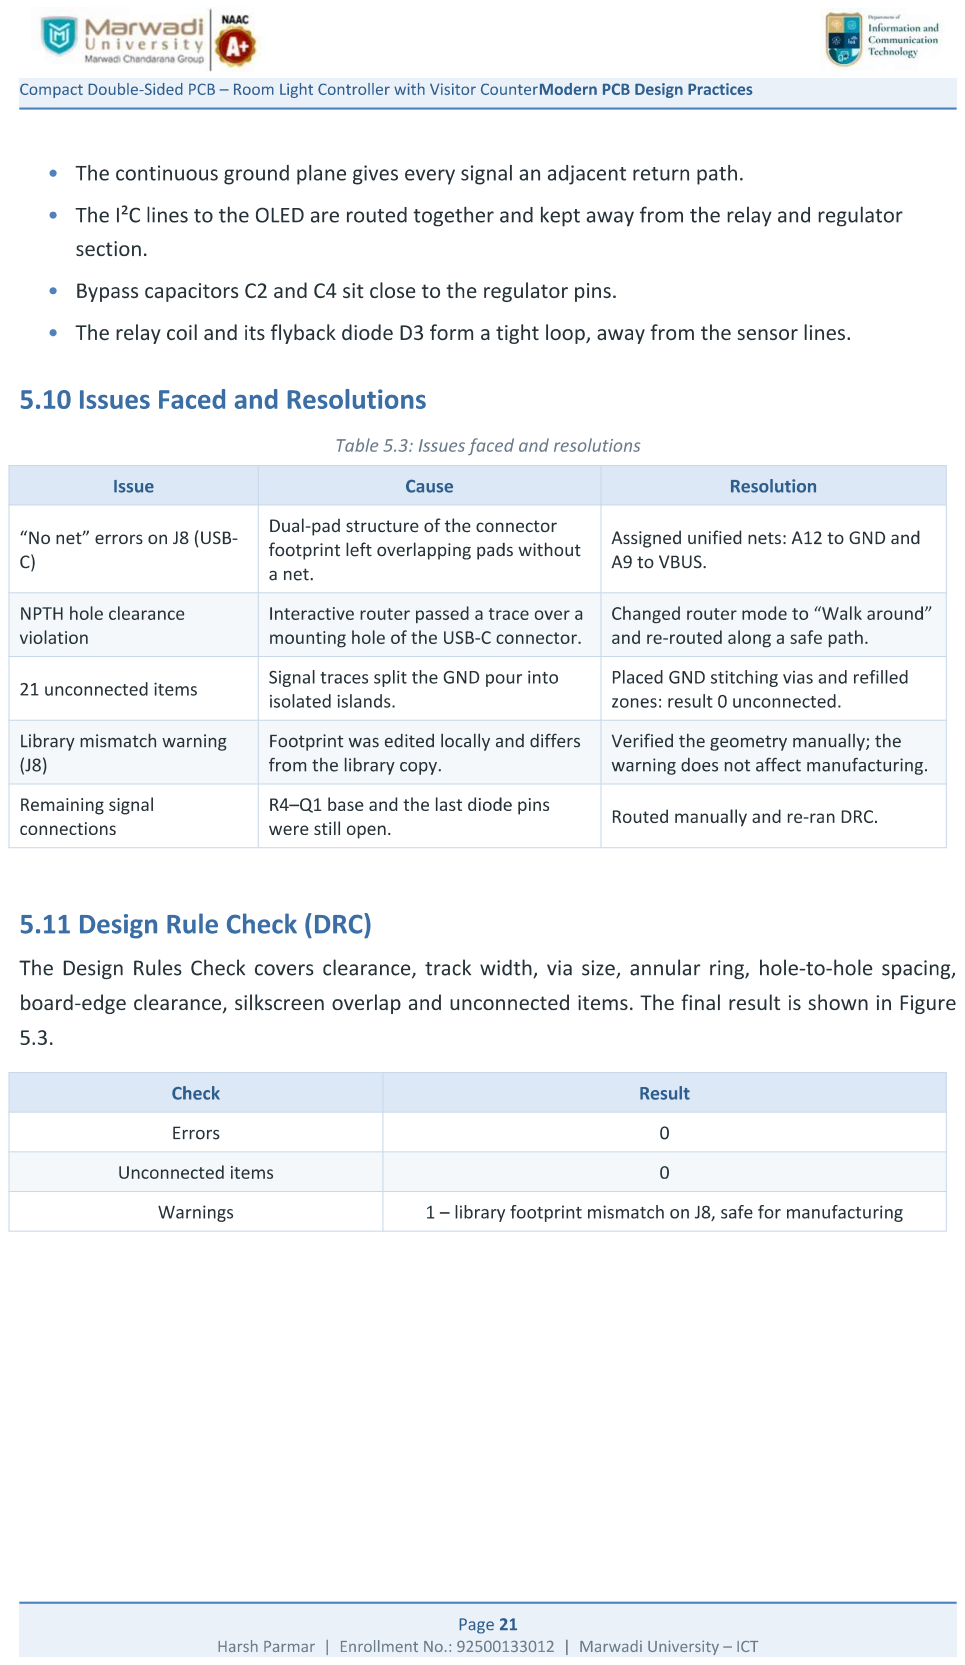
[picture p22: page 21]

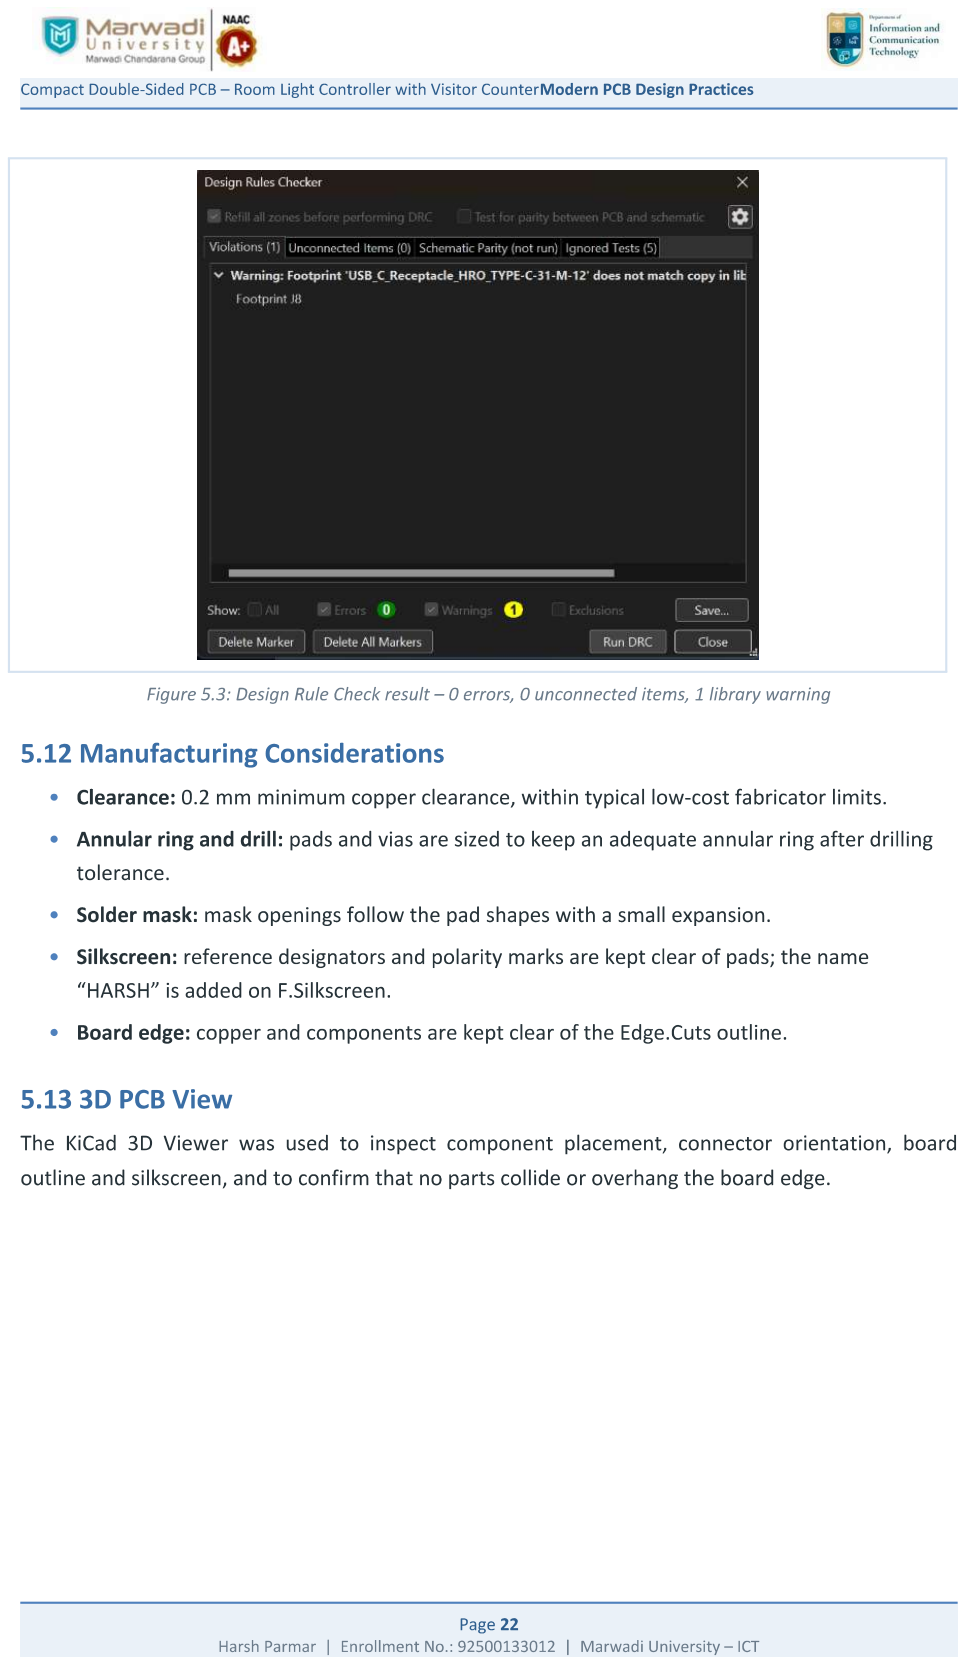
[picture p23: page 22]

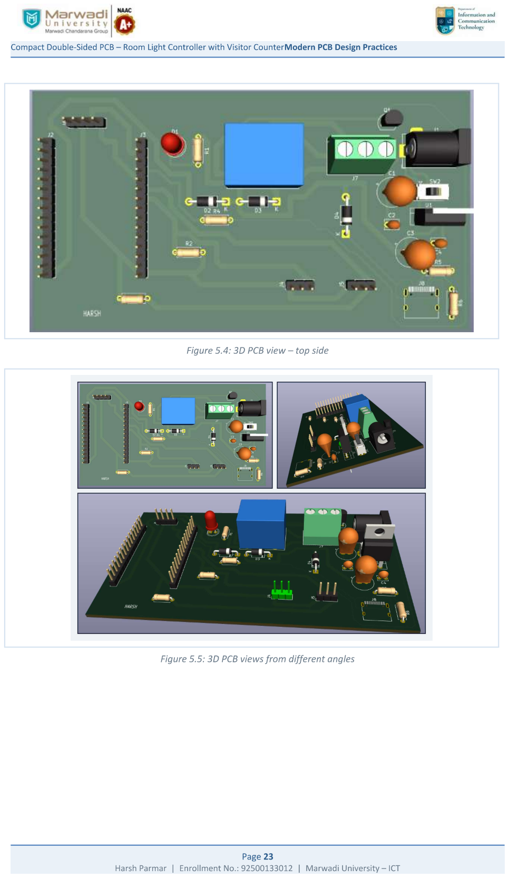
[picture p24: page 23]

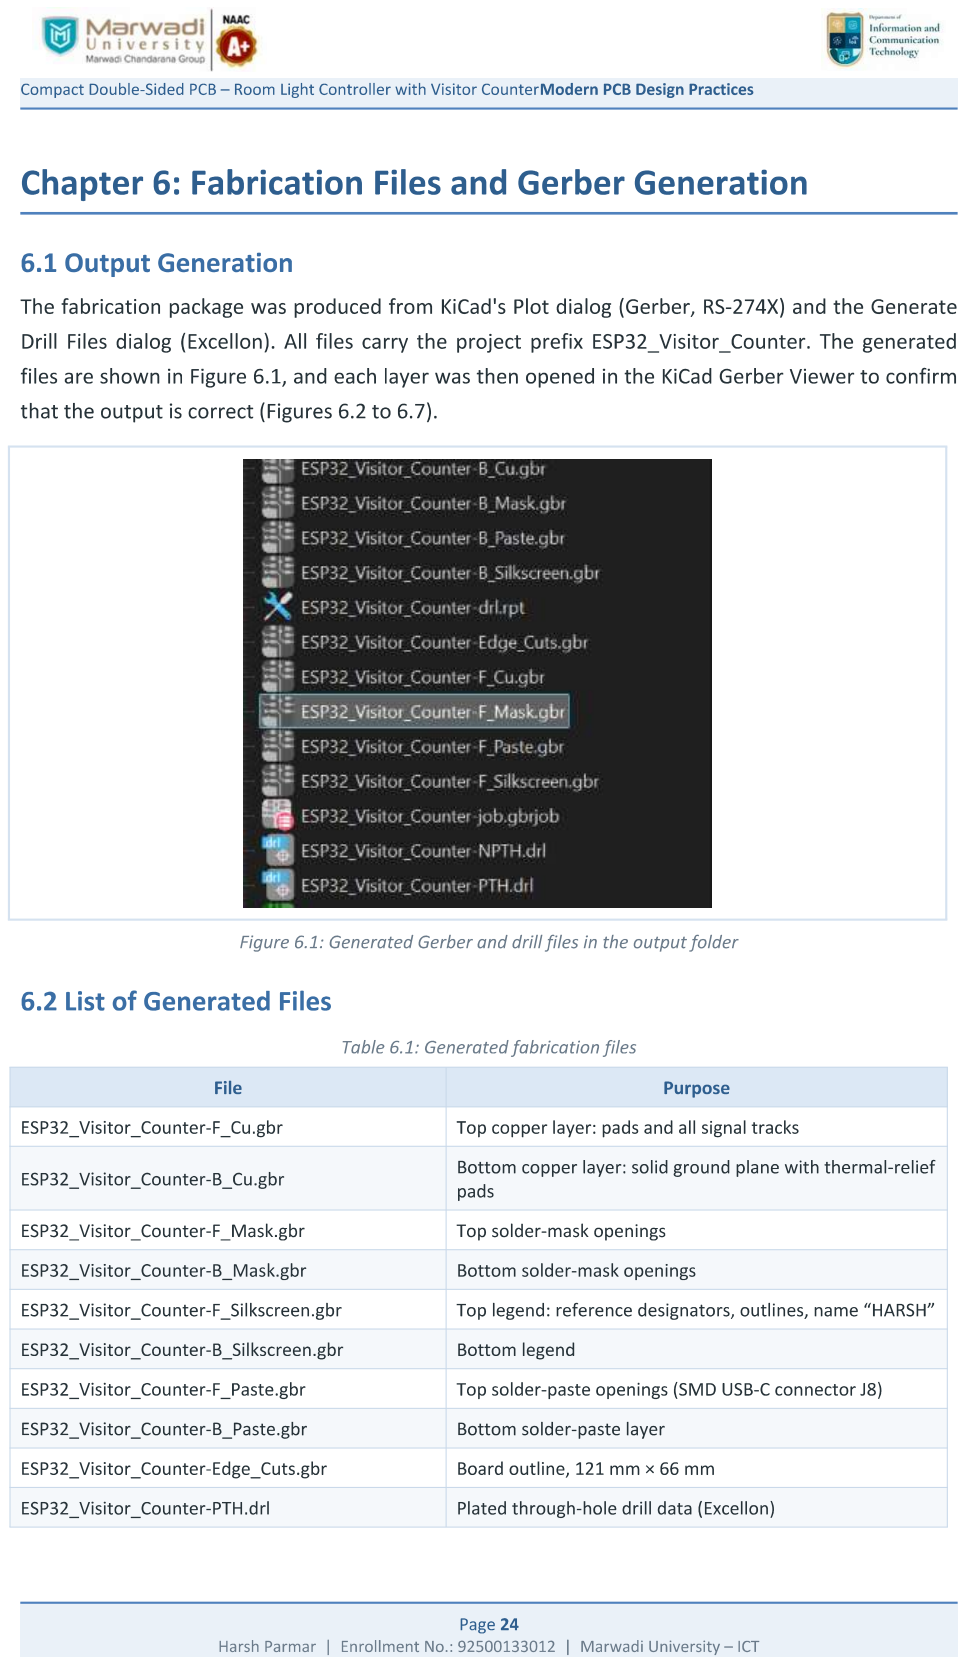
[picture p25: page 24]

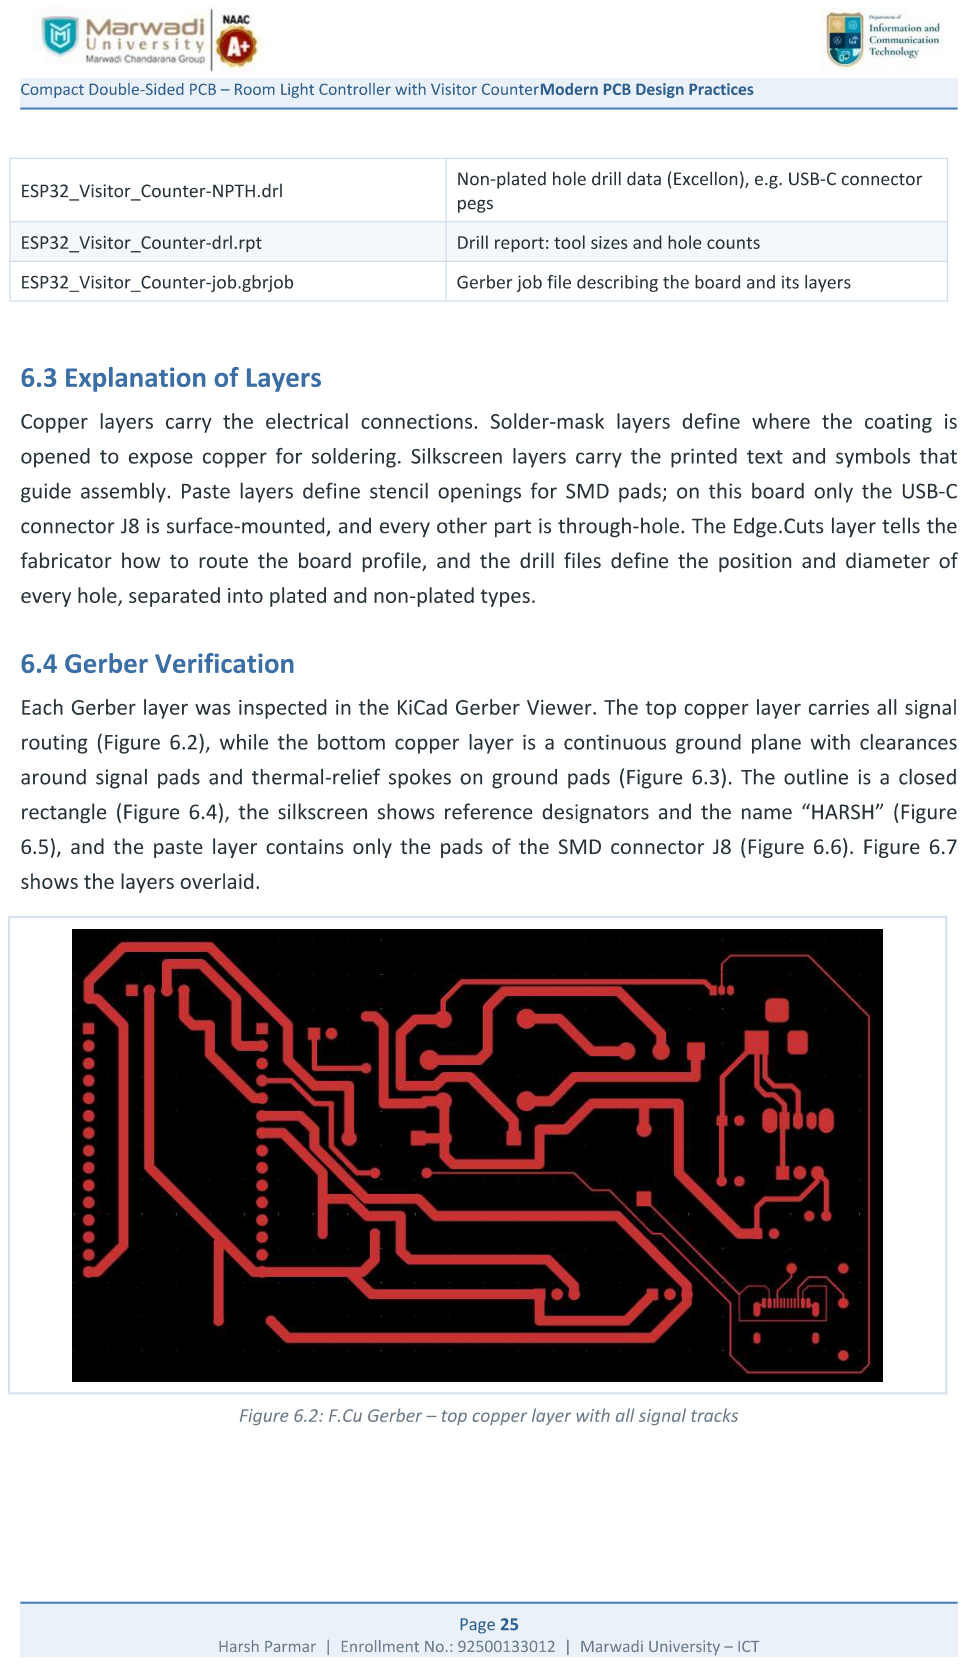
[picture p26: page 25]

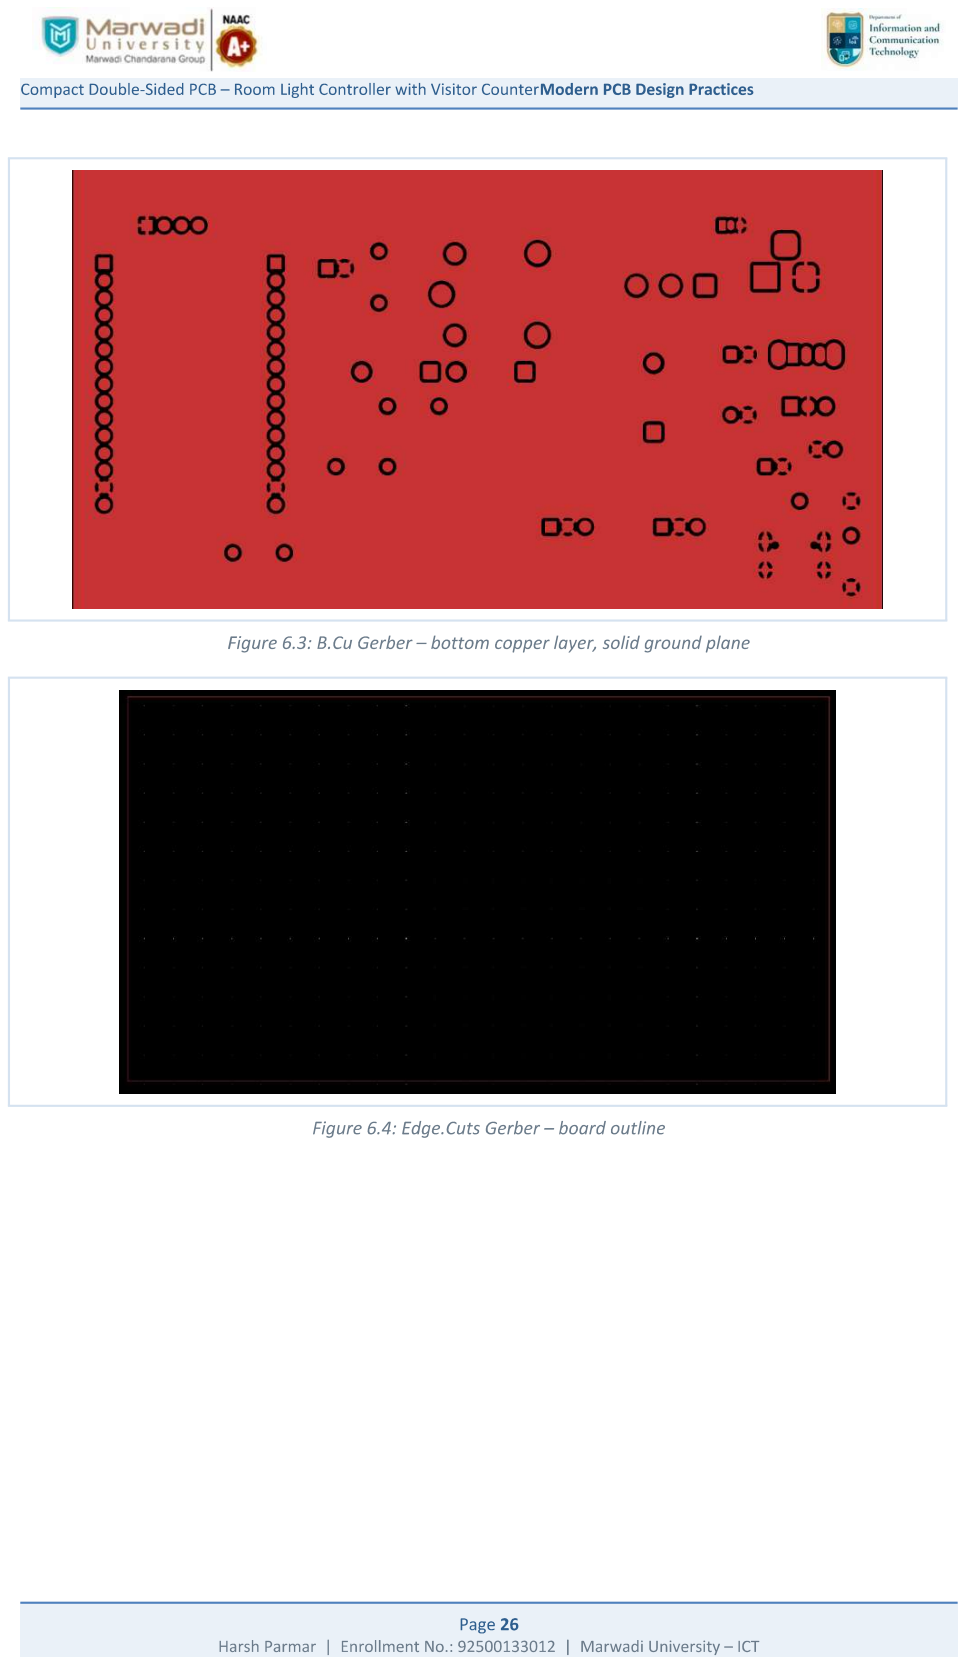
[picture p27: page 26]

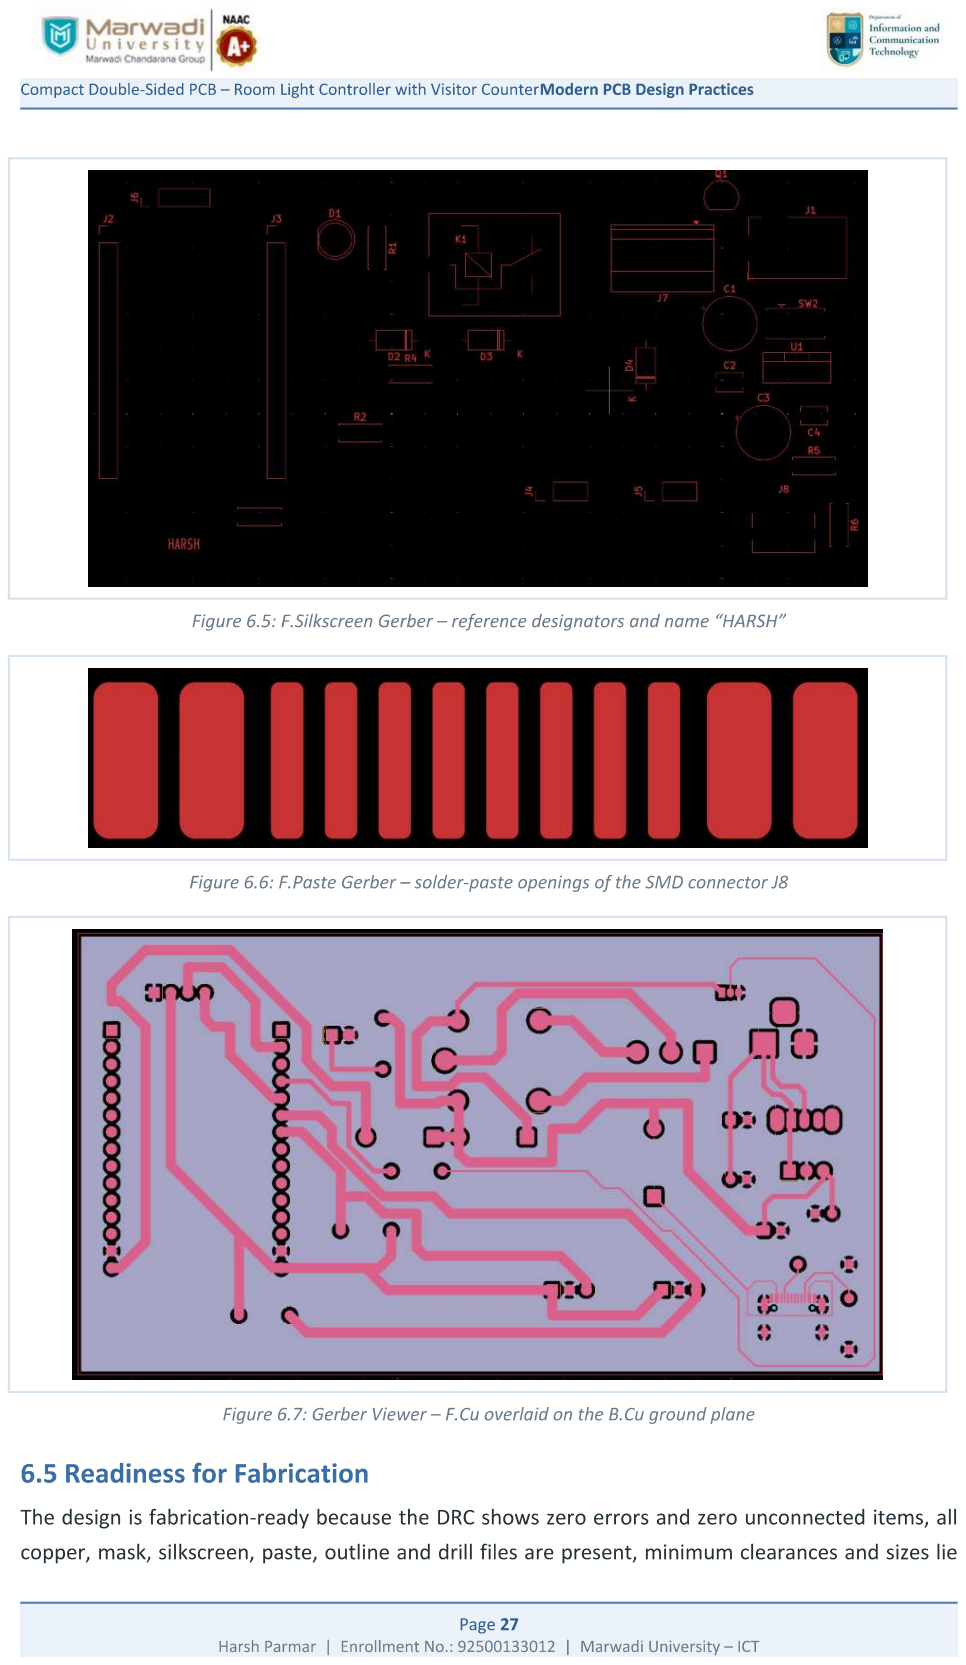
[picture p28: page 27]

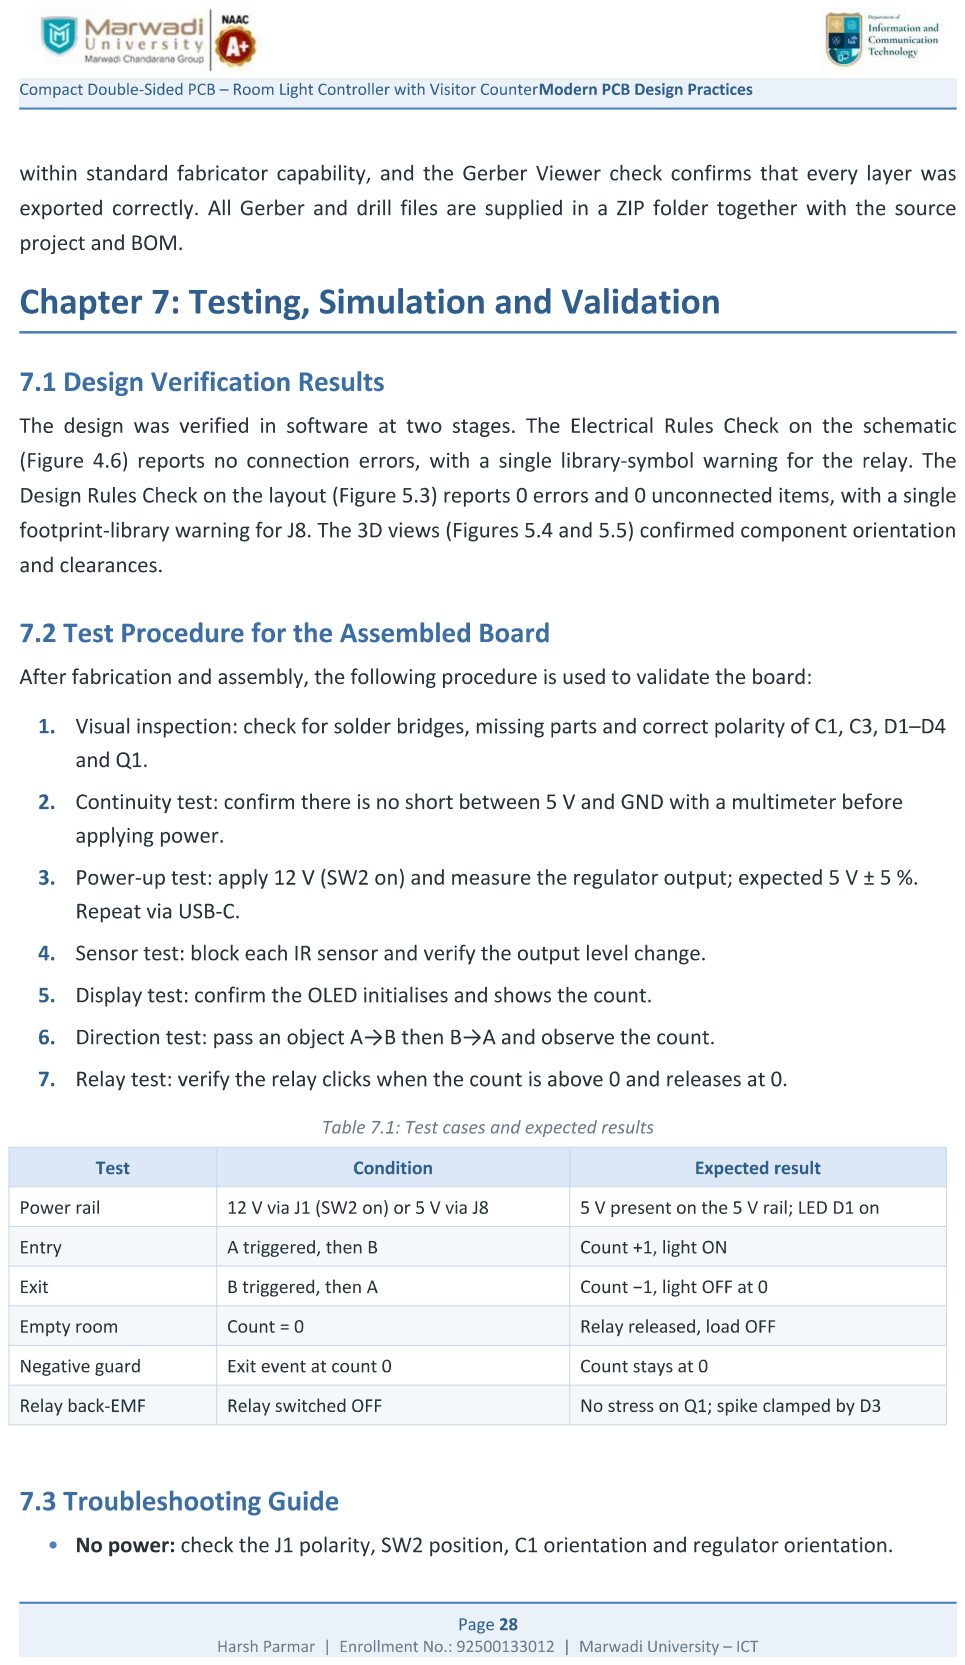
[picture p29: page 28]

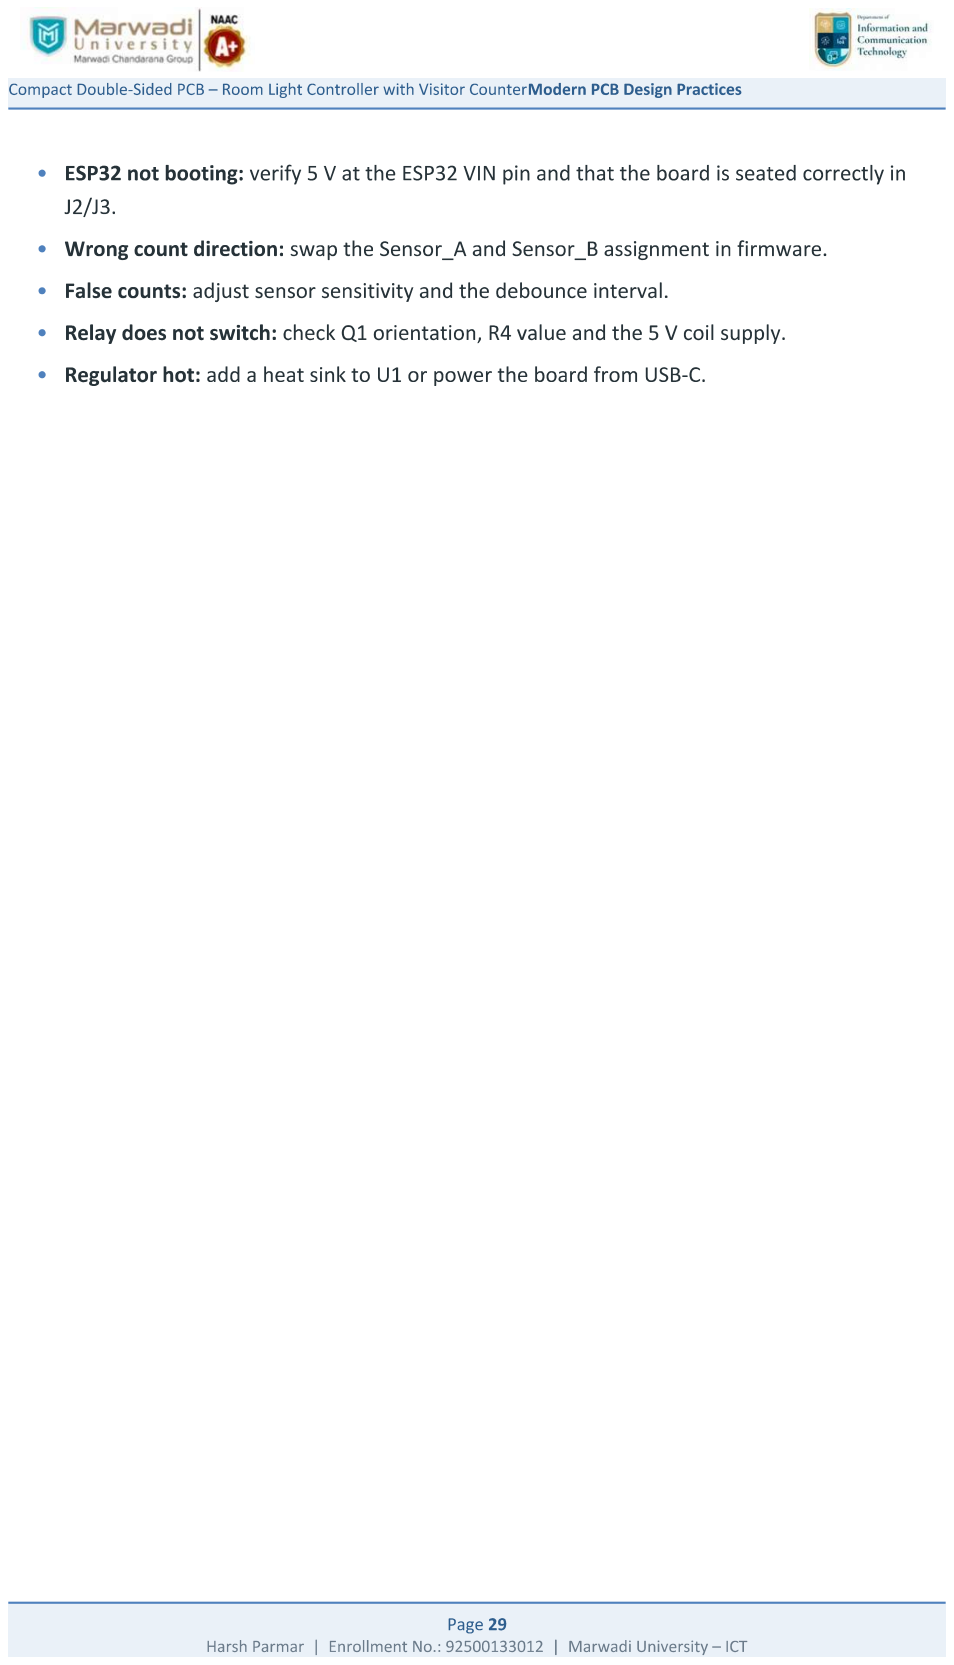
[picture p30: page 29]

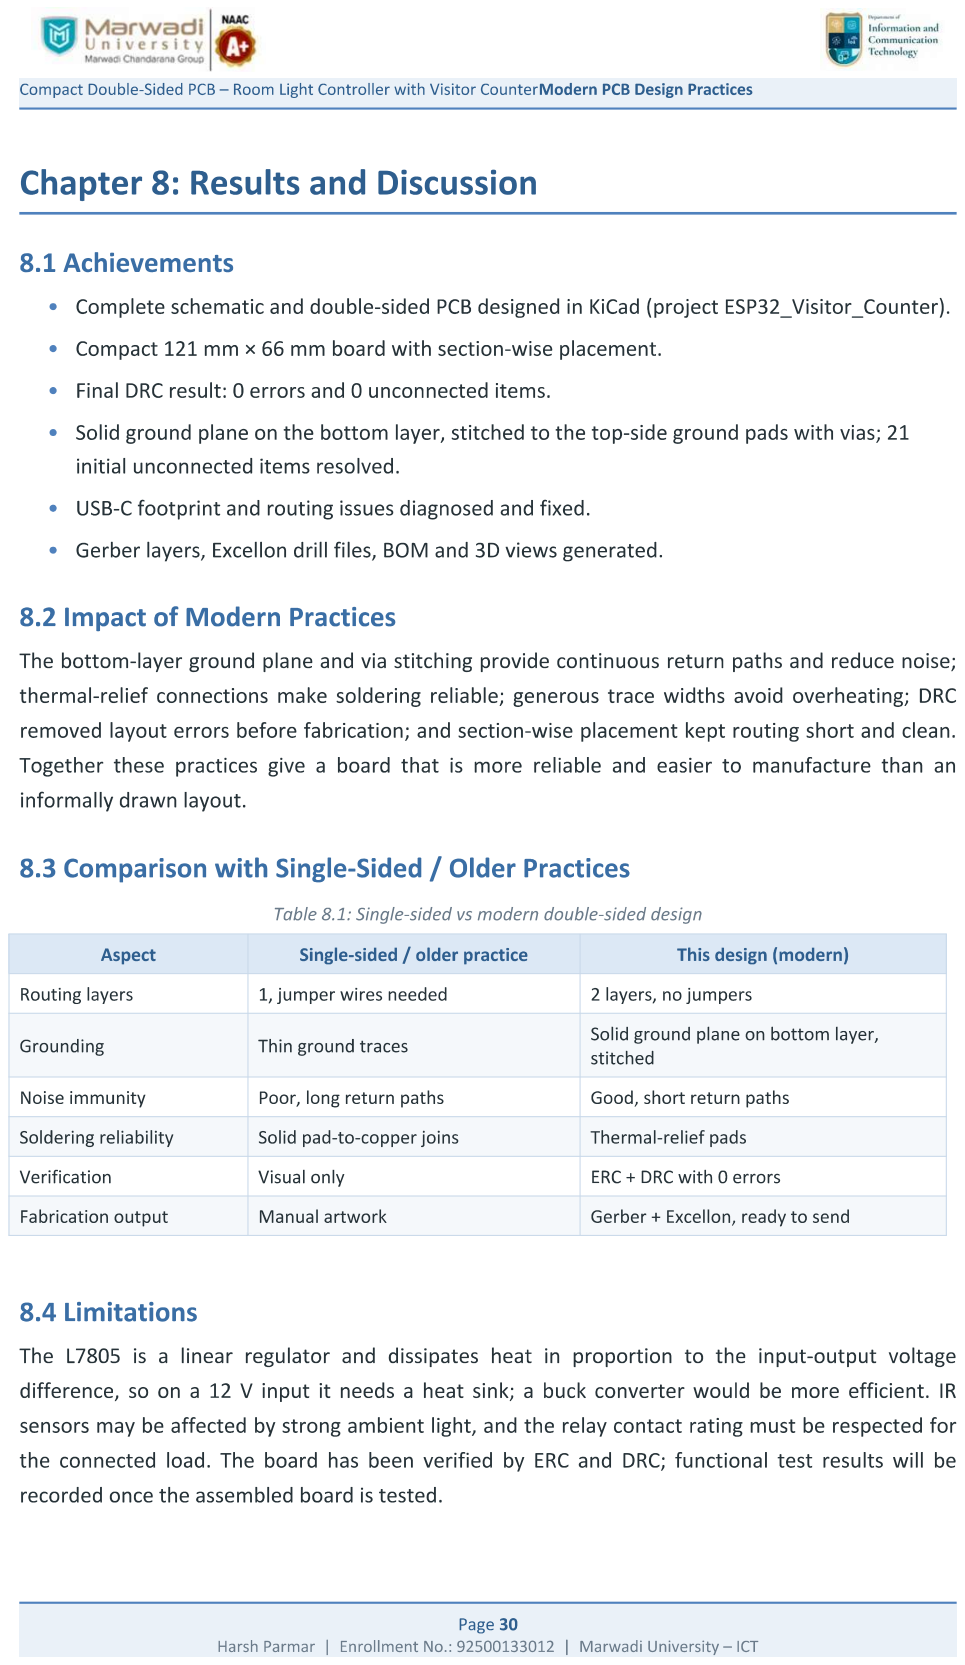
[picture p31: page 30]

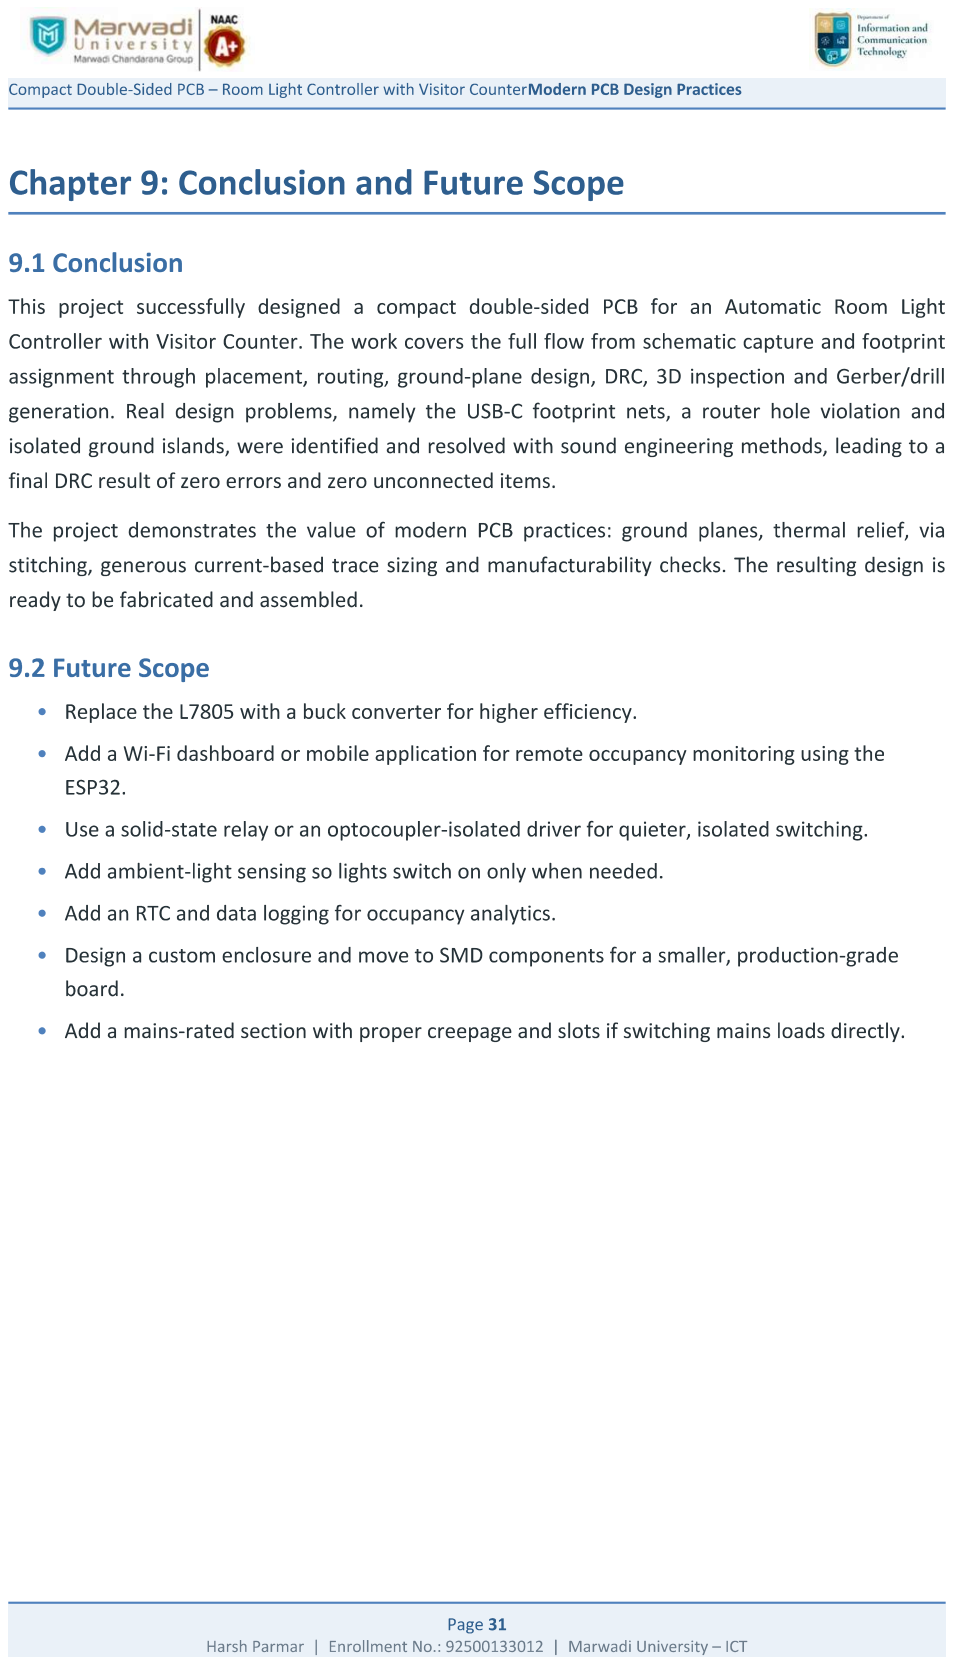
[picture p32: page 31]

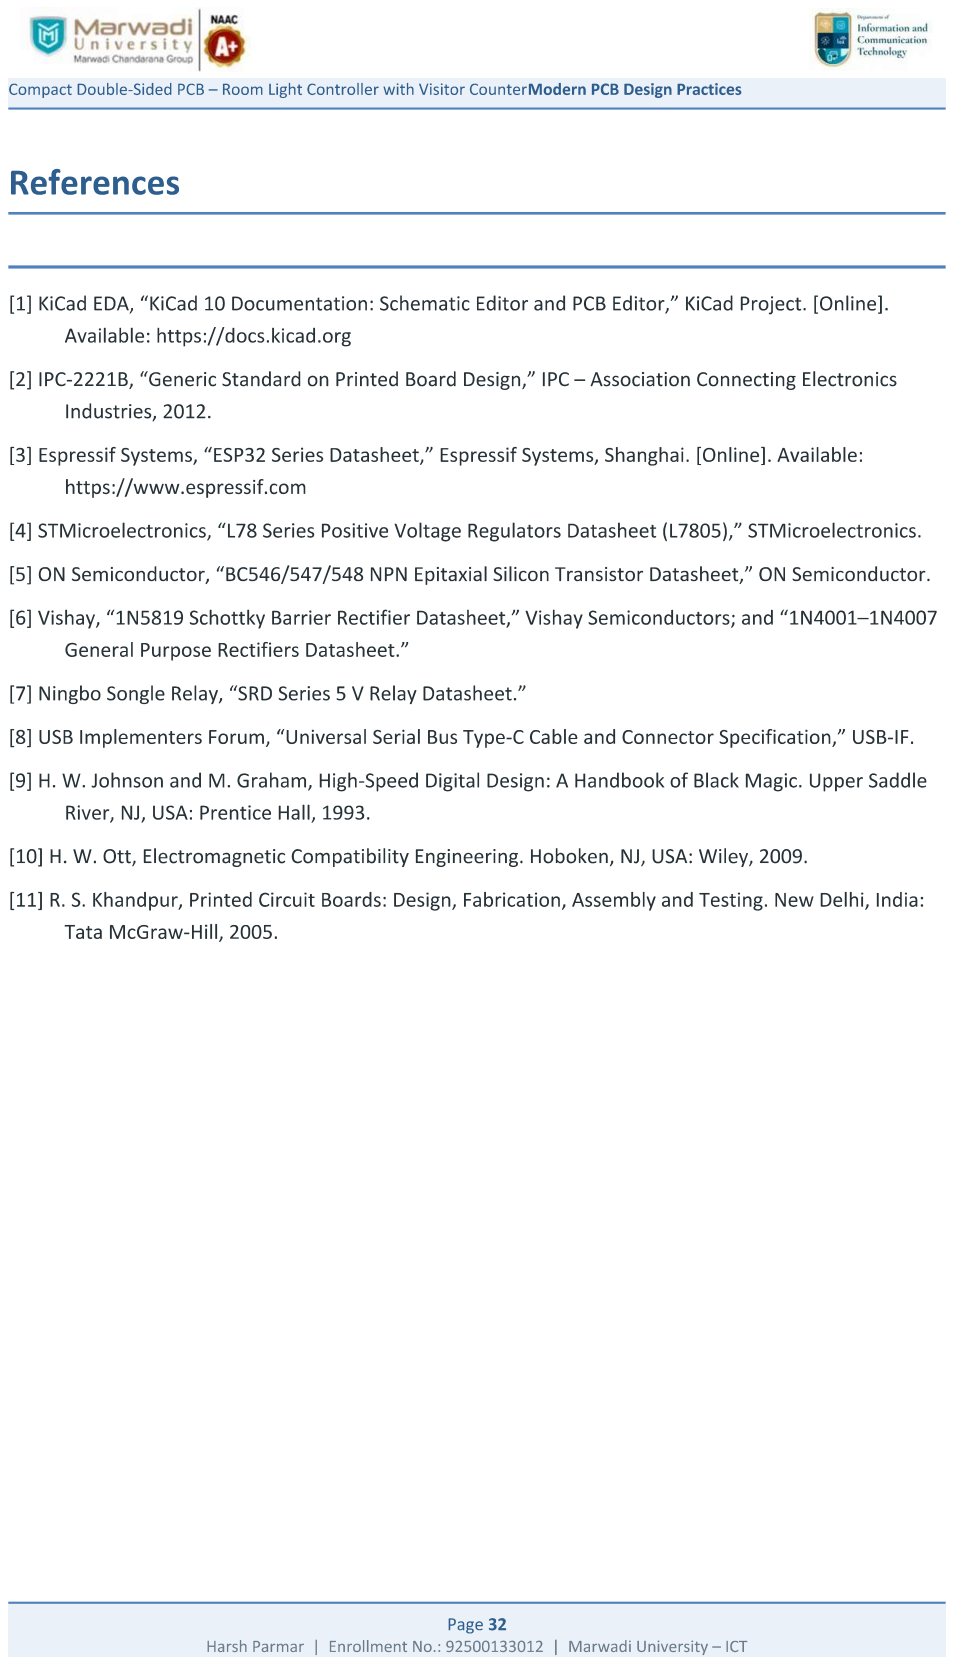
[picture p33: page 32]

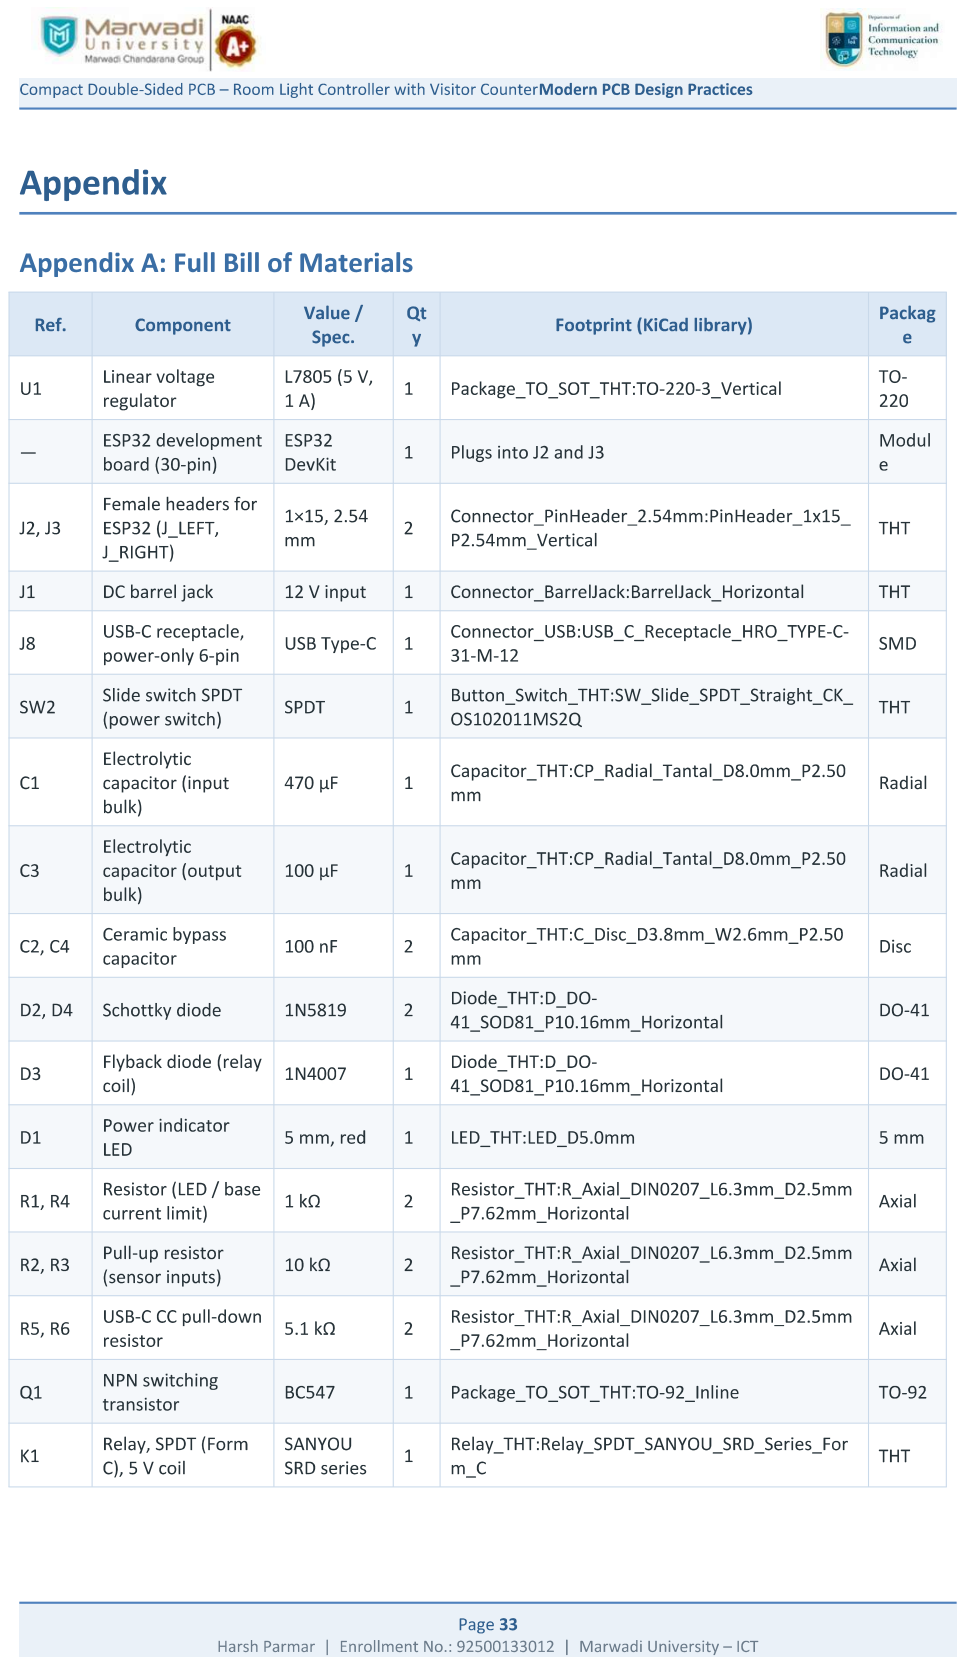
[picture p34: page 33]

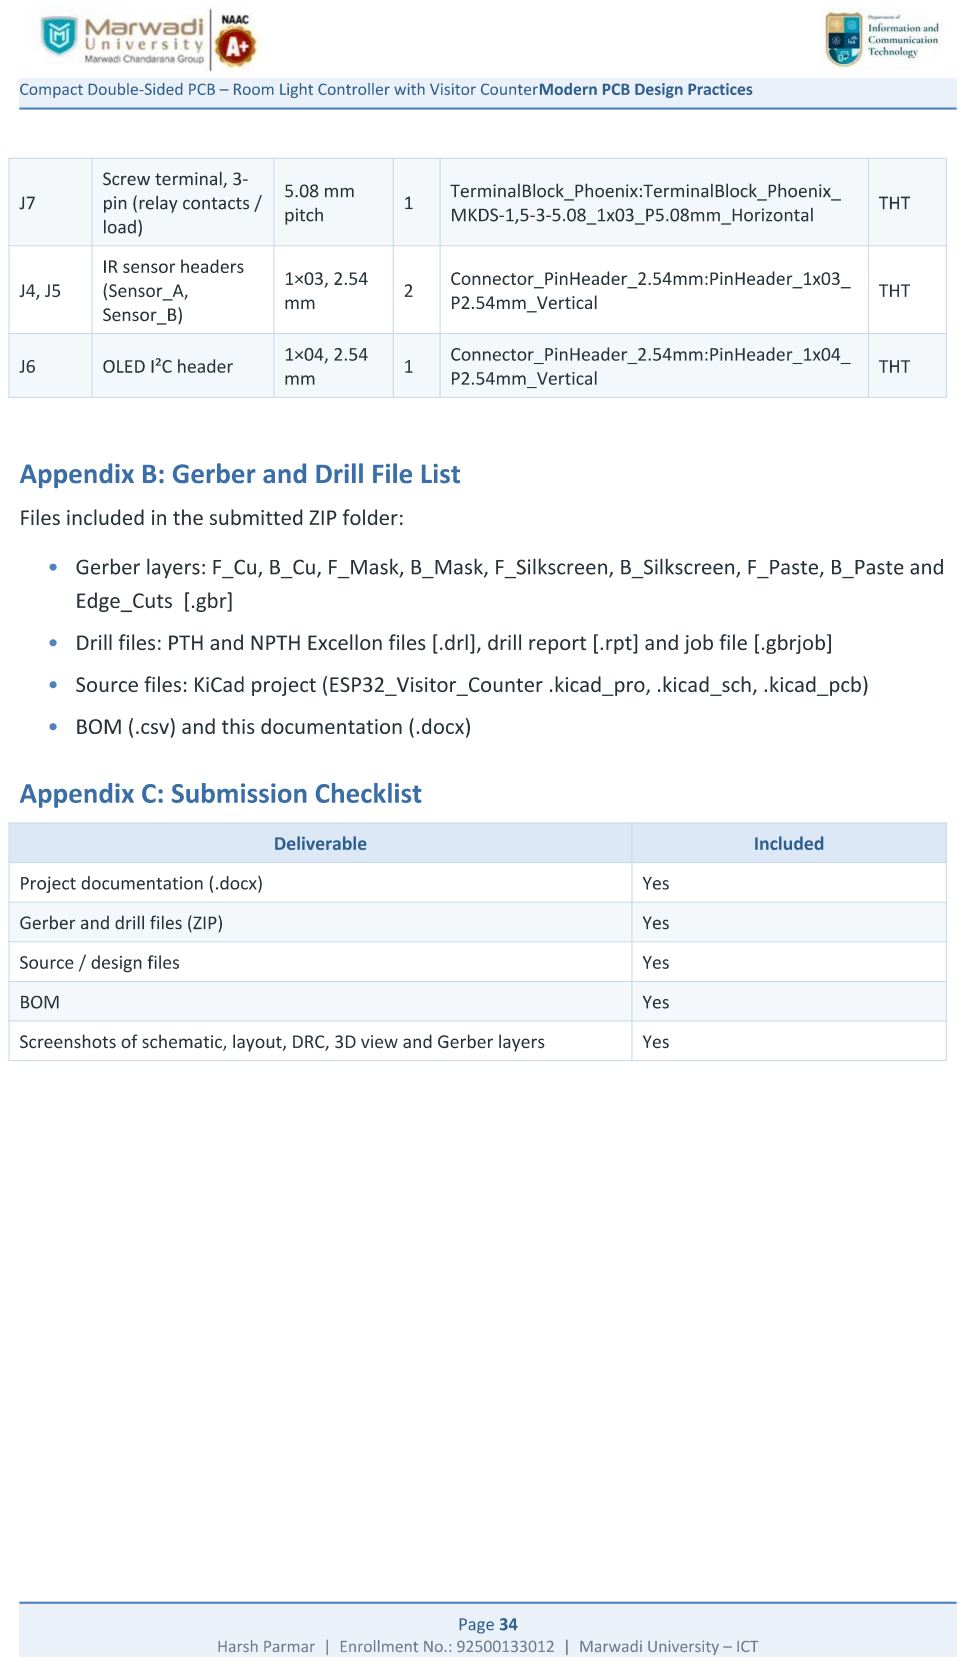
[picture p35: page 34]
