HarshParmar029/ESP32-Smart-Visitor-Counter/ESP32_Visitor_Counter.kicad_pcb

## KiCad design ESP32_Visitor_Counter.kicad_pcb (2026-10-30)

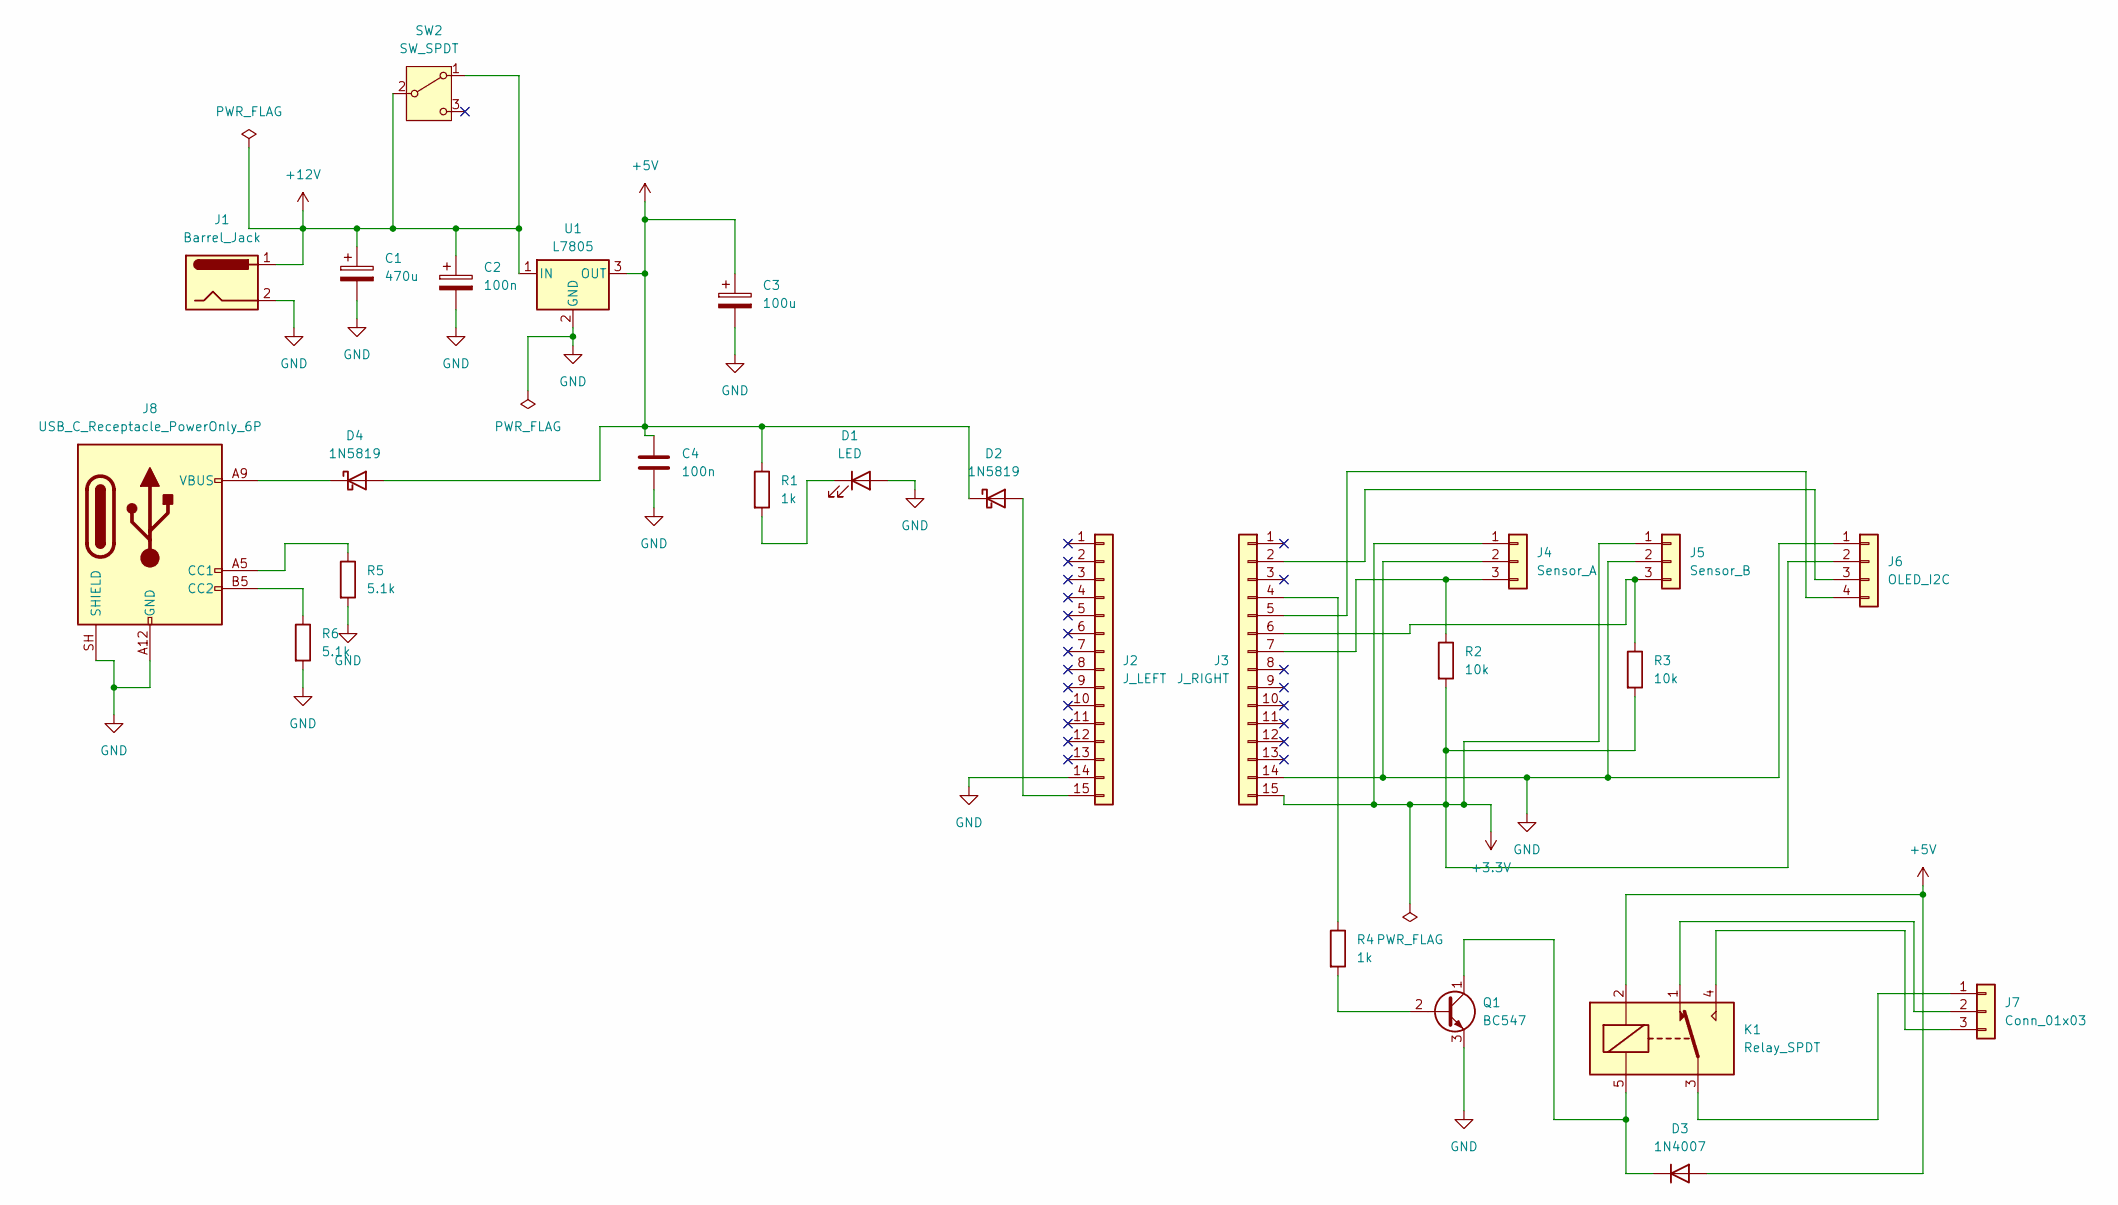
[picture p36: schematic ESP32_Visitor_Counter.kicad_sch, ESP32 Based Automatic Room Light Controller with Visitor Co…]

Parts:
C1: 470u; CP_Radial_Tantal_D8.0mm_P2.50mm
C2, C4: 100n; C_Disc_D3.8mm_W2.6mm_P2.50mm
C3: 100u; CP_Radial_Tantal_D8.0mm_P2.50mm
D1: LED; LED_D5.0mm
D2, D4: 1N5819; D_DO-41_SOD81_P10.16mm_Horizontal
D3: 1N4007; D_DO-41_SOD81_P10.16mm_Horizontal
J1: Barrel_Jack; BarrelJack_Horizontal
J2: J_LEFT; PinHeader_1x15_P2.54mm_Vertical
J3: J_RIGHT; PinHeader_1x15_P2.54mm_Vertical
J4: Sensor_A; PinHeader_1x03_P2.54mm_Vertical
J5: Sensor_B; PinHeader_1x03_P2.54mm_Vertical
J6: OLED_I2C; PinHeader_1x04_P2.54mm_Vertical
J7: Conn_01x03; TerminalBlock_Phoenix_MKDS-1,5-3-5.08_1x03_P5.08mm_Horizont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
J8: USB_C_Receptacle_PowerOnly_6P; USB_C_Receptacle_HRO_TYPE-C-31-M-12
K1: Relay_SPDT; Relay_SPDT_SANYOU_SRD_Series_Form_C
Q1: BC547; TO-92_Inline
R1, R4: 1k; R_Axial_DIN0207_L6.3mm_D2.5mm_P7.62mm_Horizontal
R2, R3: 10k; R_Axial_DIN0207_L6.3mm_D2.5mm_P7.62mm_Horizontal
R5, R6: 5.1k; R_Axial_DIN0207_L6.3mm_D2.5mm_P7.62mm_Horizontal
SW2: SW_SPDT; SW_Slide_SPDT_Straight_CK_OS102011MS2Q
U1: L7805; TO-220-3_Vertical

Connections:
+3.3V: J3.15, J4.1, J5.1, J6.2, R2.2, R3.2
+5V: C3.1, C4.1, D2.1 (K), D3.2 (A), D4.2 (A), K1.2, R1.1, U1.3 (OUT)
+12V: C1.1, C2.1, J1.1, SW2.1 (A), SW2.2 (B), U1.1 (IN)
GND: C1.2, C2.2, C3.2, C4.2, D1.2 (A), J1.2, J2.14, J3.14, J4.2, J5.2, J6.1, J8.A1 (GND_A12), J8.A12 (GND_A12), J8.B1 (GND_A12), J8.B12 (GND_A12), J8.SH (SHIELD_SH), Q1.3 (E), R5.2, R6.2, U1.2 (GND)
unnamed: D1.1 (K), R1.2
unnamed: D2.2 (A), J2.15
unnamed: D3.1 (K), K1.5, Q1.1 (C)
unnamed: D4.1 (K), J8.A4 (VBUS_A9), J8.A9 (VBUS_A9), J8.B4 (VBUS_A9), J8.B9 (VBUS_A9)
unnamed: J3.2, J6.3
unnamed: J3.4, R4.1
unnamed: J3.5, J6.4
unnamed: J3.6, J5.3, R3.1
unnamed: J3.7, J4.3, R2.1
unnamed: J7.1, K1.3
unnamed: J7.2, K1.1
unnamed: J7.3, K1.4
unnamed: J8.A5 (CC1_A5), R5.1
unnamed: J8.B5 (CC2_B5), R6.1
unnamed: Q1.2 (B), R4.2

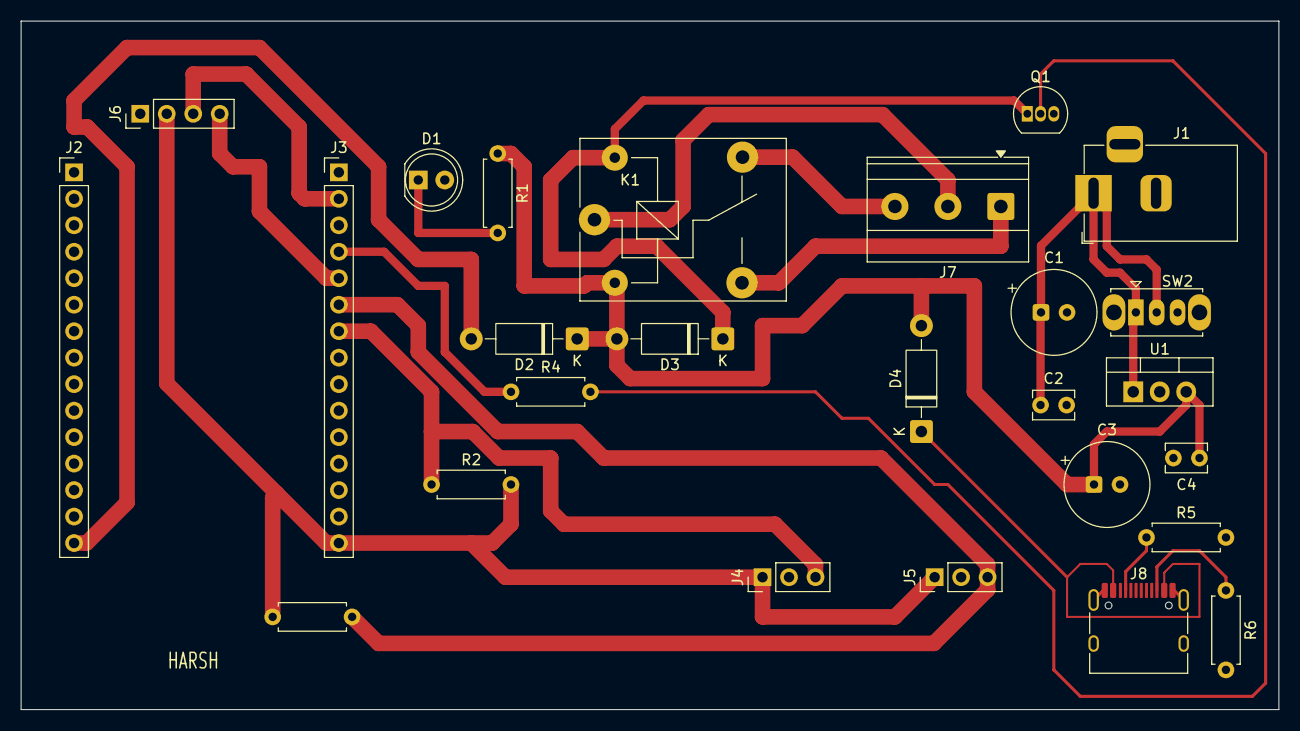
[picture p37: board ESP32_Visitor_Counter.kicad_pcb from above]

Board: 2 copper layers, 120.7 x 66.0 mm, 26 parts (0 on the bottom side), 19 nets.
